MatheusOgata/TCC-FESP/escrita/experimental/28-10-noaa18/NOAA-IMG.jpg

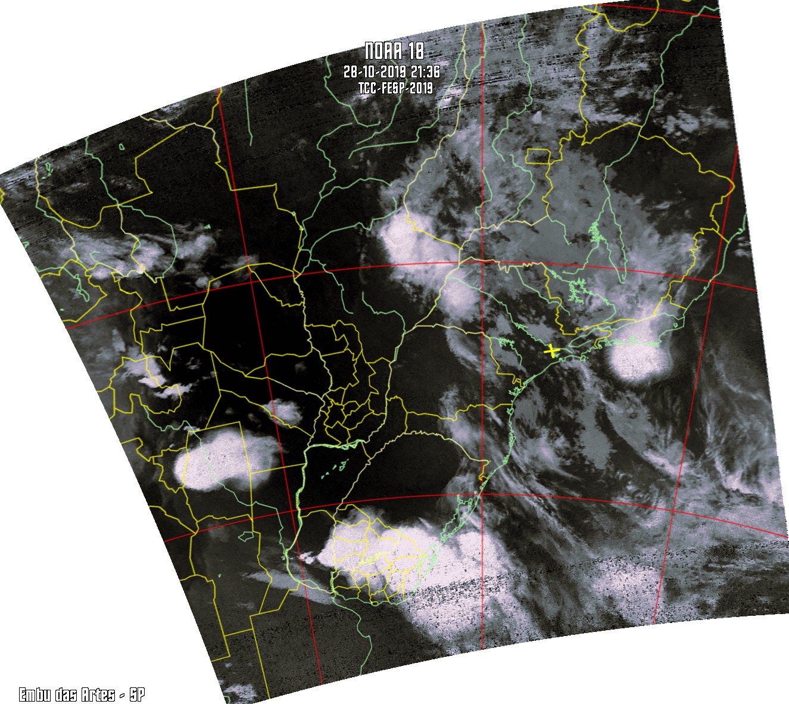
escrita/experimental/28-10-noaa18/NOAA-IMG.jpg
