MatheusOgata/TCC-FESP/escrita/experimental/record option.JPG

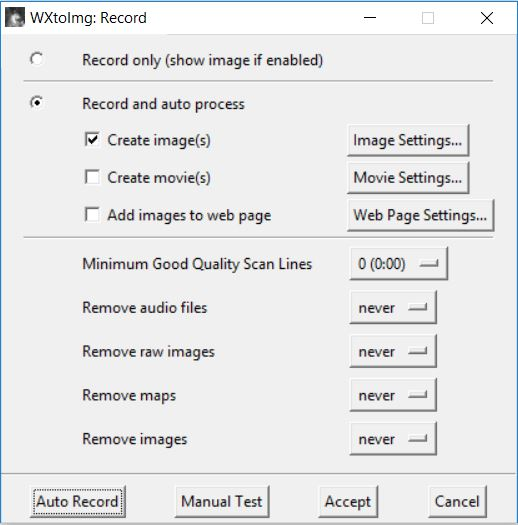
escrita/experimental/record option.JPG
