MatheusOgata/TCC-FESP/escrita/intro/blockstream3.png

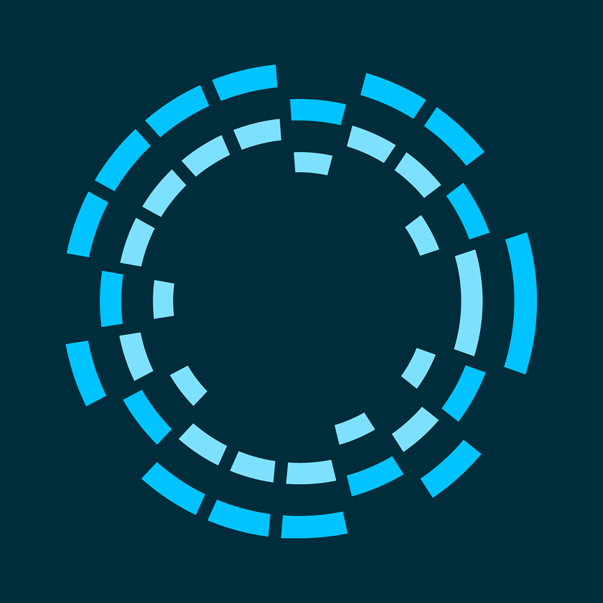
escrita/intro/blockstream3.png
