MatheusOgata/TCC-FESP/escrita/pesquisa-antena/plano de captura.JPG

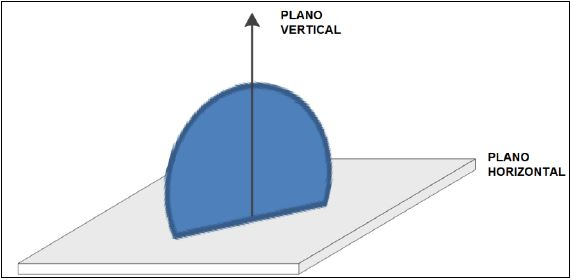
escrita/pesquisa-antena/plano de captura.JPG
