MatheusOgata/TCC-FESP/escrita/pesquisa-antena/simulacao modelo antena/medidas simulacao antena.JPG

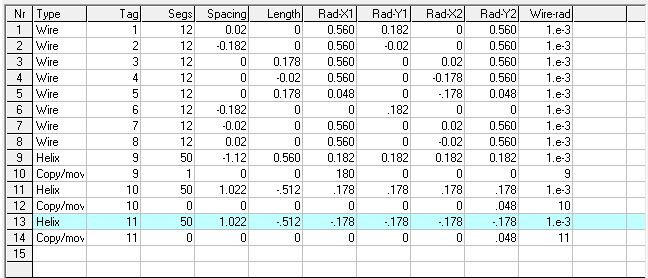
escrita/pesquisa-antena/simulacao modelo antena/medidas simulacao antena.JPG
