MatheusOgata/TCC-FESP/escrita/pesquisa-satelite/apt2.JPG

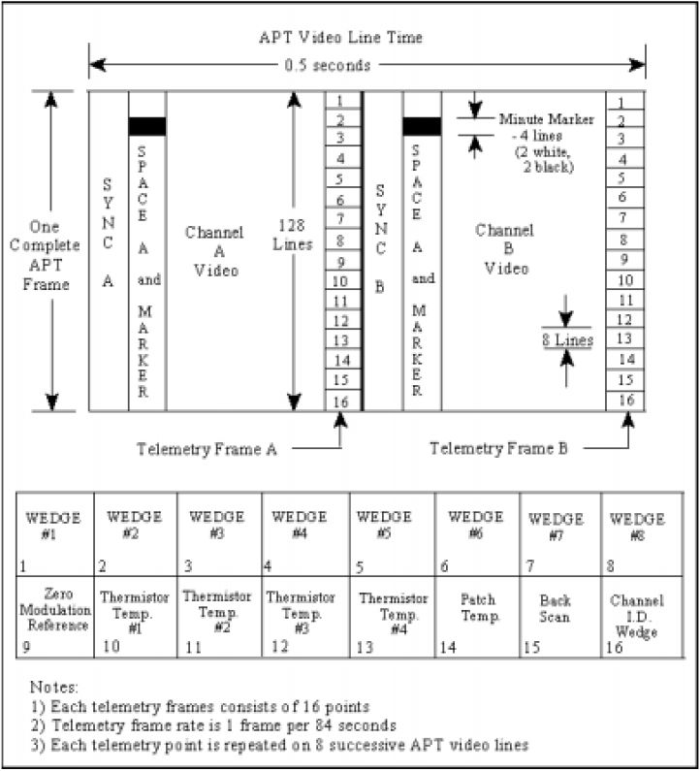
escrita/pesquisa-satelite/apt2.JPG
