MatheusOgata/TCC-FESP/escrita/pesquisa-satelite/AVHRR.jpg

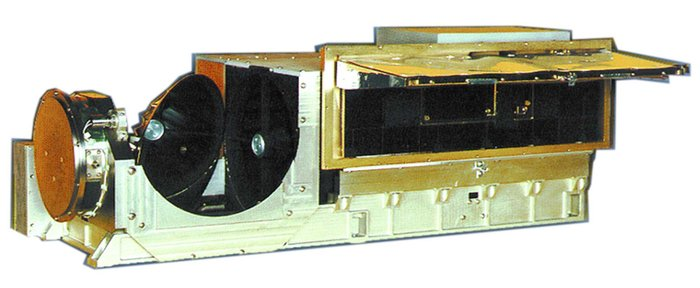
escrita/pesquisa-satelite/AVHRR.jpg
