MatheusOgata/TCC-FESP/escrita/pesquisa-satelite/BANDEIRA NOAA.png

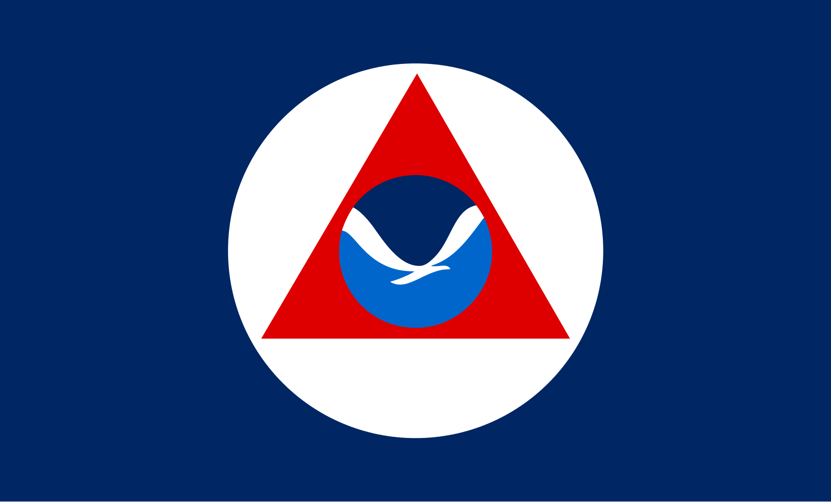
escrita/pesquisa-satelite/BANDEIRA NOAA.png
