MatheusOgata/TCC-FESP/escrita/pesquisa-satelite/color hrpt.JPG

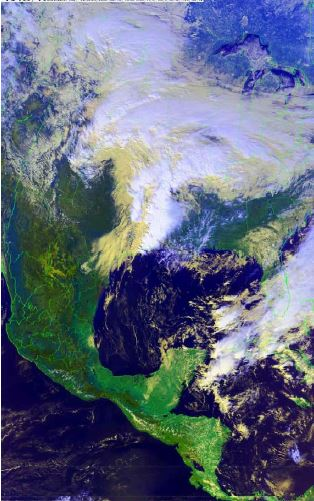
escrita/pesquisa-satelite/color hrpt.JPG
