MatheusOgata/TCC-FESP/escrita/pesquisa-satelite/escanemento.JPG

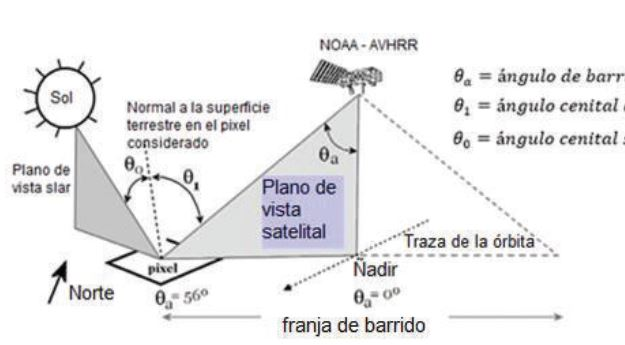
escrita/pesquisa-satelite/escanemento.JPG
