MatheusOgata/TCC-FESP/escrita/pesquisa-satelite/noaa19.jpg

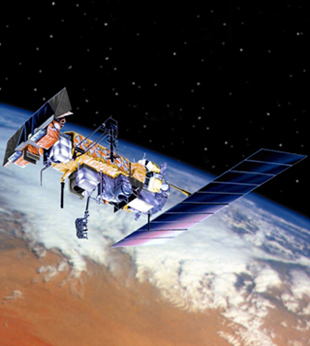
escrita/pesquisa-satelite/noaa19.jpg
