MatheusOgata/TCC-FESP/escrita/pesquisa-satelite/noaa subsistemas.JPG

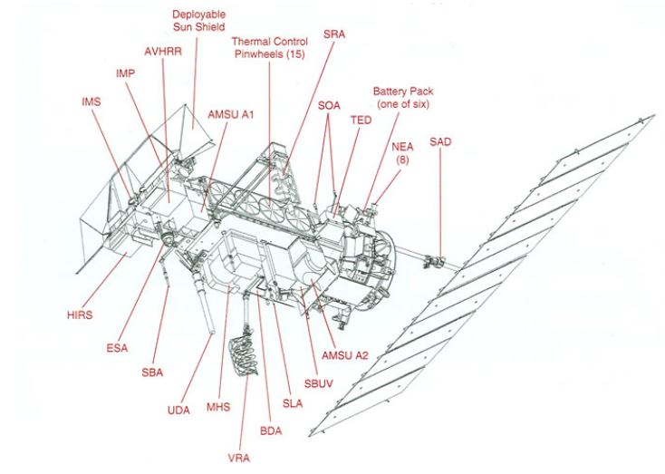
escrita/pesquisa-satelite/noaa subsistemas.JPG
