MatheusOgata/TCC-FESP/escrita/pesquisa-satelite/sistema espacial.JPG

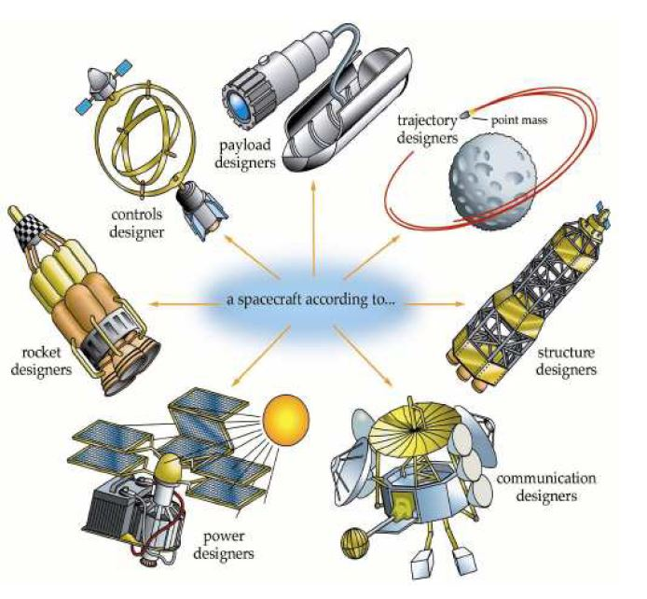
escrita/pesquisa-satelite/sistema espacial.JPG
