MatheusOgata/TCC-FESP/escrita/pesquisa-satelite/US DEP COMMERCE.png

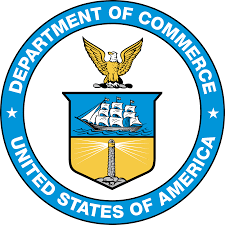
escrita/pesquisa-satelite/US DEP COMMERCE.png
