MatheusOgata/TCC-FESP/escrita/experimental/4h58-noaa19-1709/NOAA-IMG5.jpg

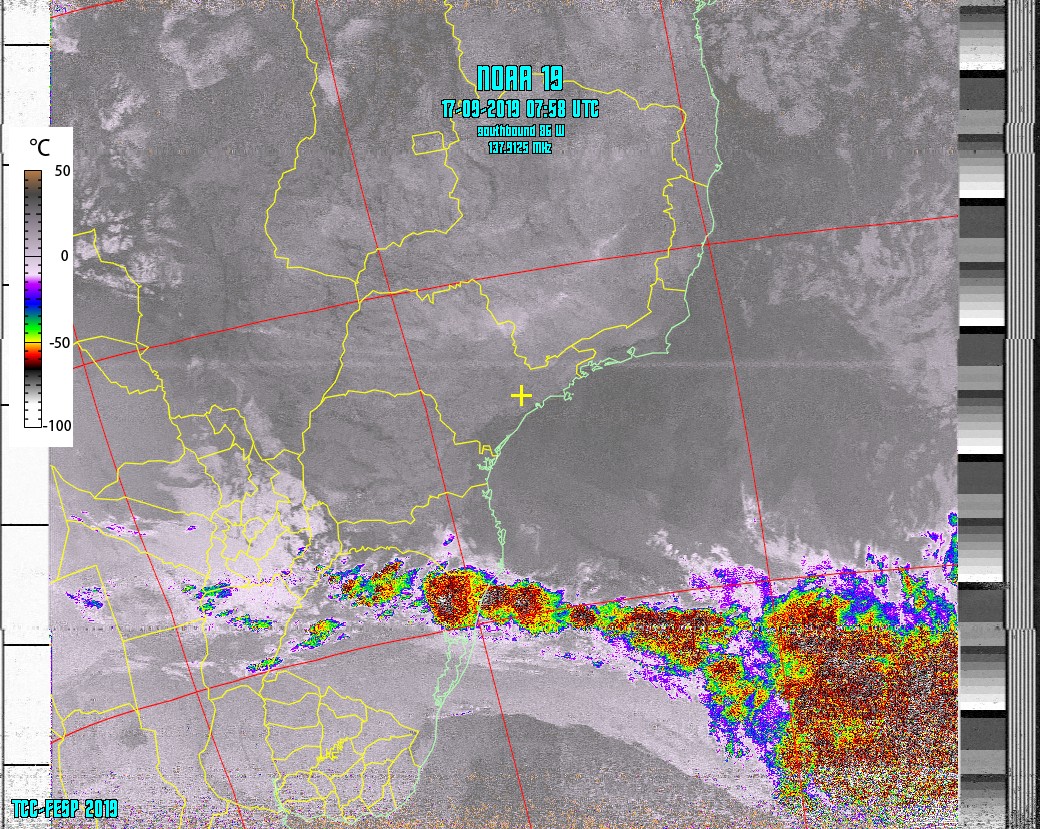
escrita/experimental/4h58-noaa19-1709/NOAA-IMG5.jpg
