MatheusOgata/TCC-FESP/escrita/experimental/4h58-noaa19-1709/nuvens-relevo-ir.jpg

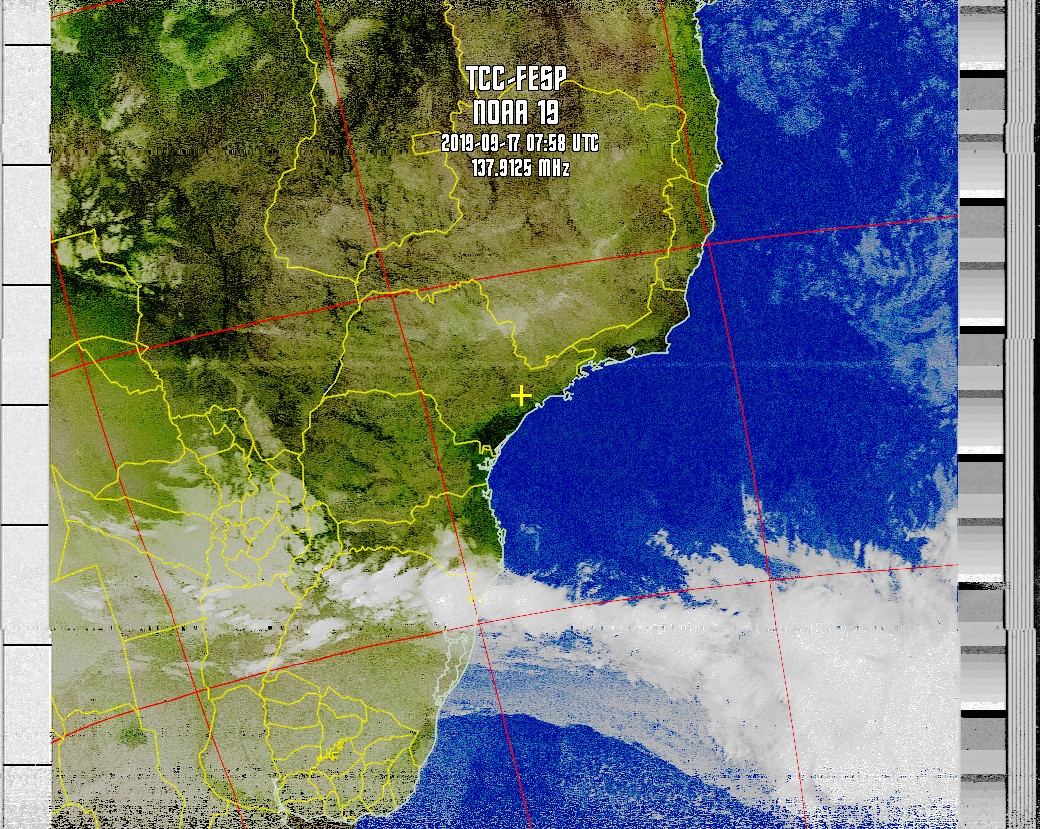
escrita/experimental/4h58-noaa19-1709/nuvens-relevo-ir.jpg
