MatheusOgata/TCC-FESP/escrita/experimental/5h-noaa19-1609/11.JPG

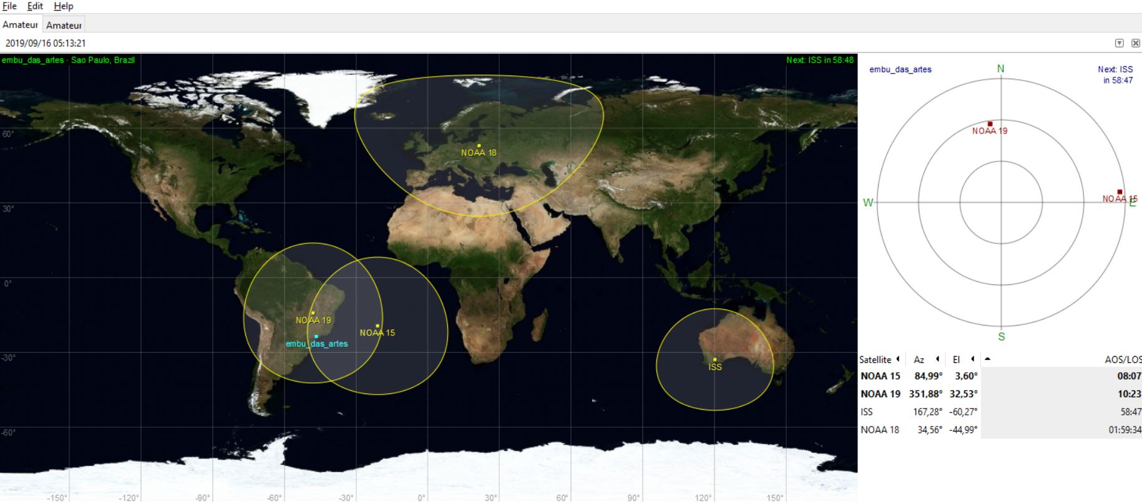
escrita/experimental/5h-noaa19-1609/11.JPG
