MatheusOgata/TCC-FESP/escrita/experimental/5h-noaa19-1609/22.JPG

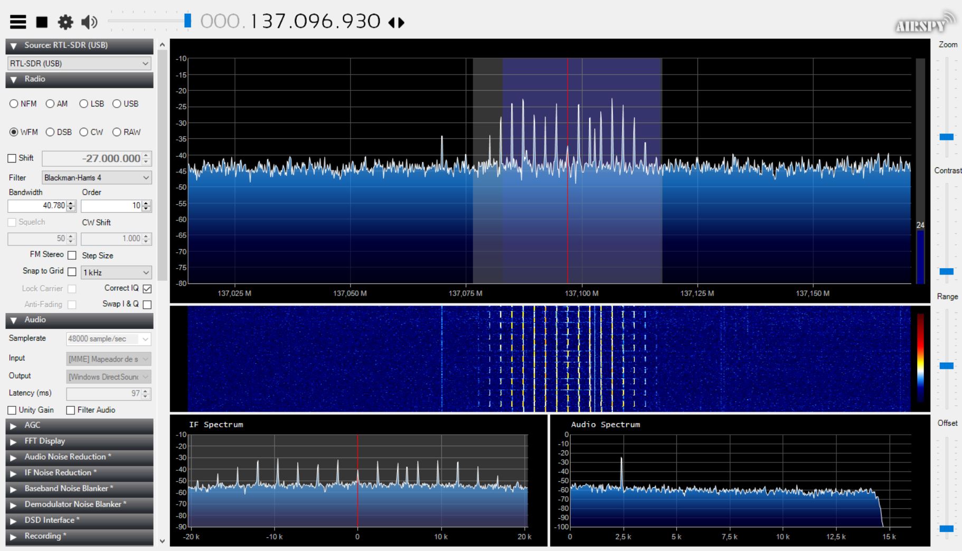
escrita/experimental/5h-noaa19-1609/22.JPG
