MatheusOgata/TCC-FESP/escrita/experimental/5h-noaa19-1609/33.JPG

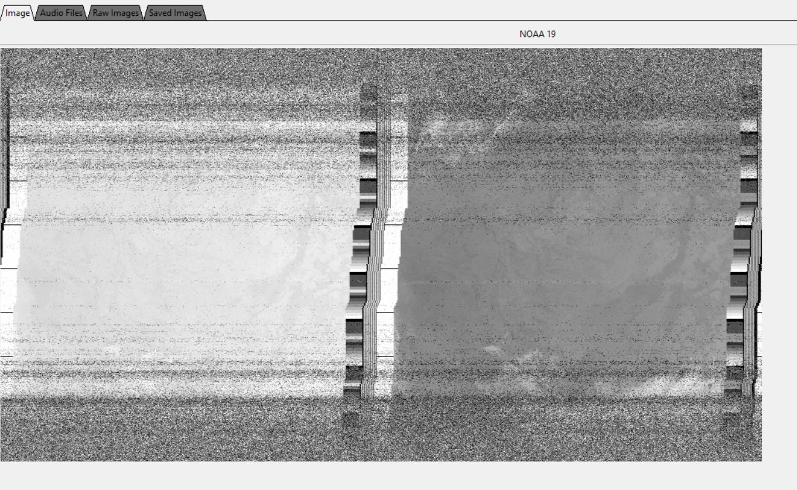
escrita/experimental/5h-noaa19-1609/33.JPG
