MatheusOgata/TCC-FESP/escrita/experimental/5h-noaa19-1609/noaa19termal.jpg

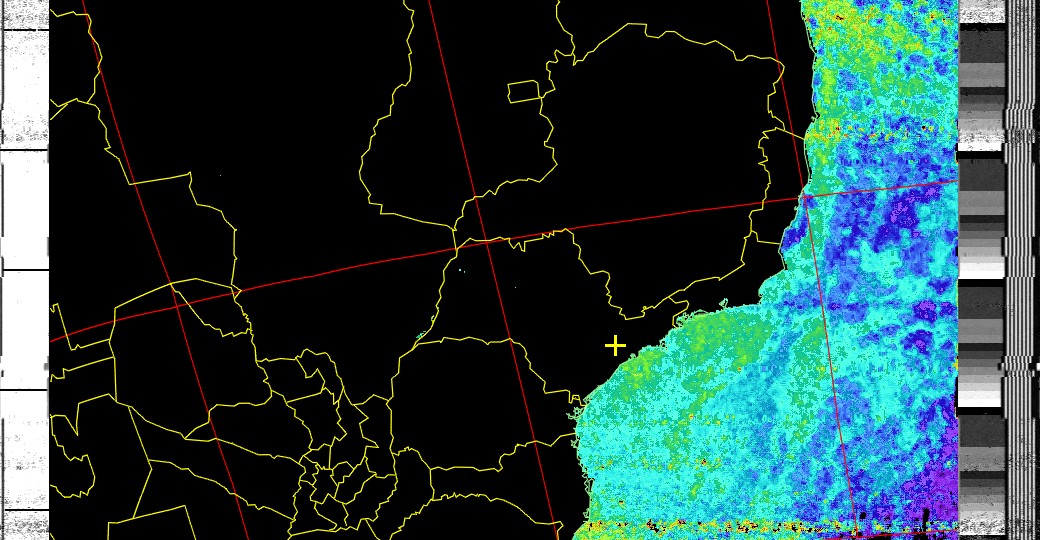
escrita/experimental/5h-noaa19-1609/noaa19termal.jpg
