MatheusOgata/TCC-FESP/escrita/experimental/5h-noaa19-1609/noaa19thermal2.jpg

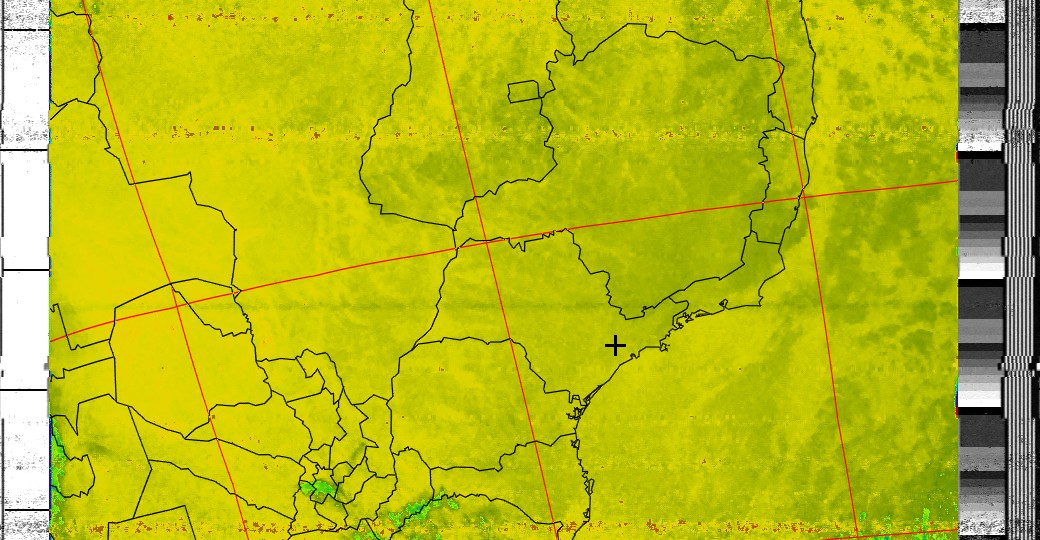
escrita/experimental/5h-noaa19-1609/noaa19thermal2.jpg
