MatheusOgata/TCC-FESP/escrita/experimental/5h-noaa19-1609/noaa-19-201909160810-mcir.jpg

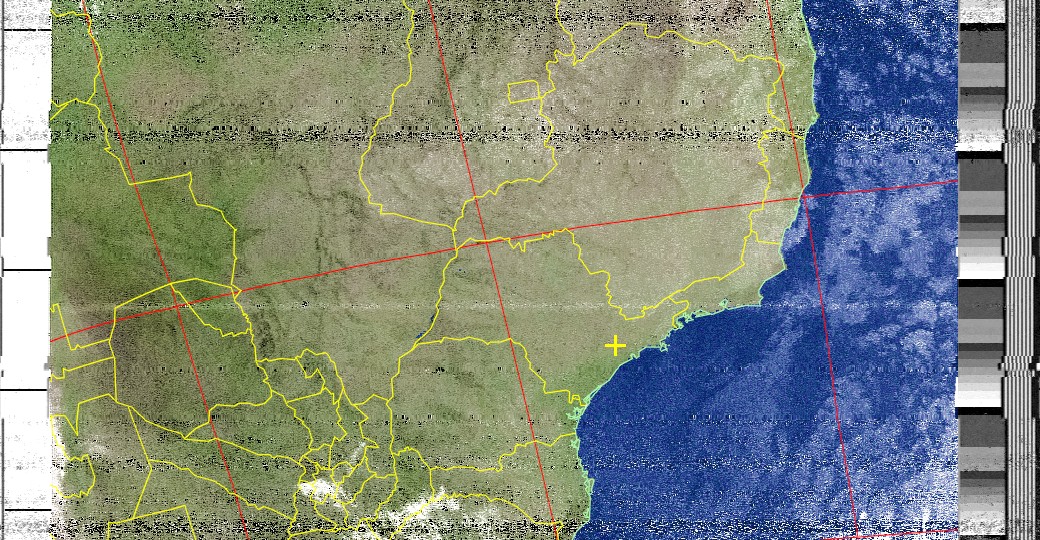
escrita/experimental/5h-noaa19-1609/noaa-19-201909160810-mcir.jpg
