MatheusOgata/TCC-FESP/escrita/experimental/8h30-noaa-18-1310/NOAA-18-13-10-prec.jpg

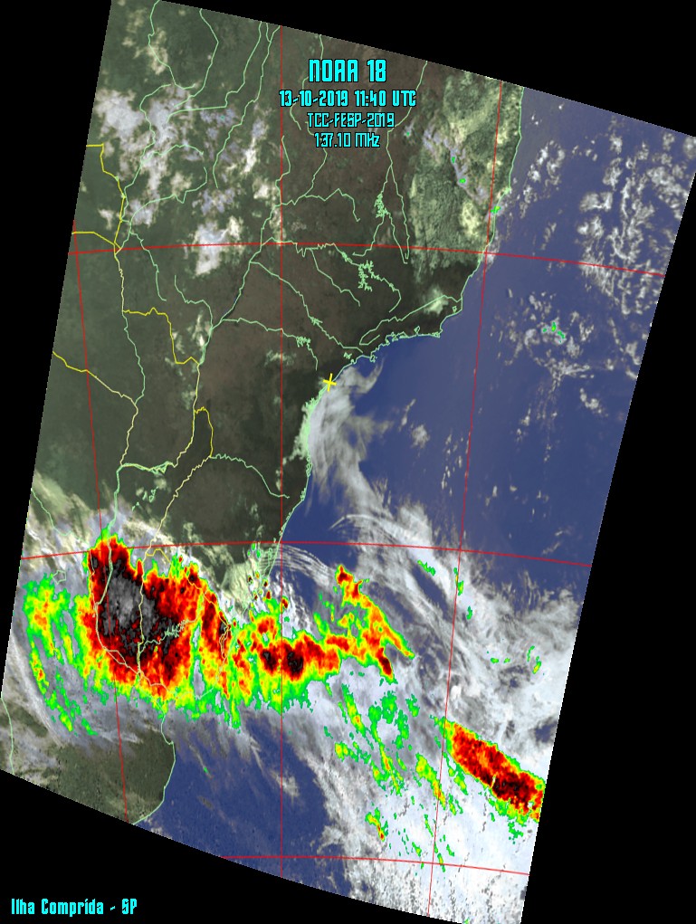
escrita/experimental/8h30-noaa-18-1310/NOAA-18-13-10-prec.jpg
