MatheusOgata/TCC-FESP/escrita/experimental/8h30-noaa-18-1310/weather-channel-13-10-precipitacao.JPG

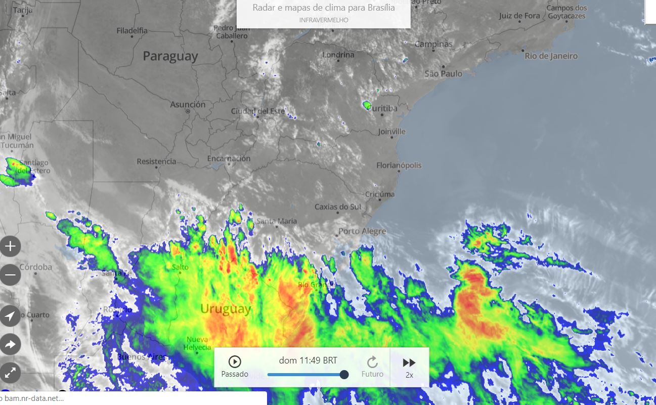
escrita/experimental/8h30-noaa-18-1310/weather-channel-13-10-precipitacao.JPG
