MatheusOgata/TCC-FESP/escrita/experimental/12-10-noaa19/12-10-noaa19.png

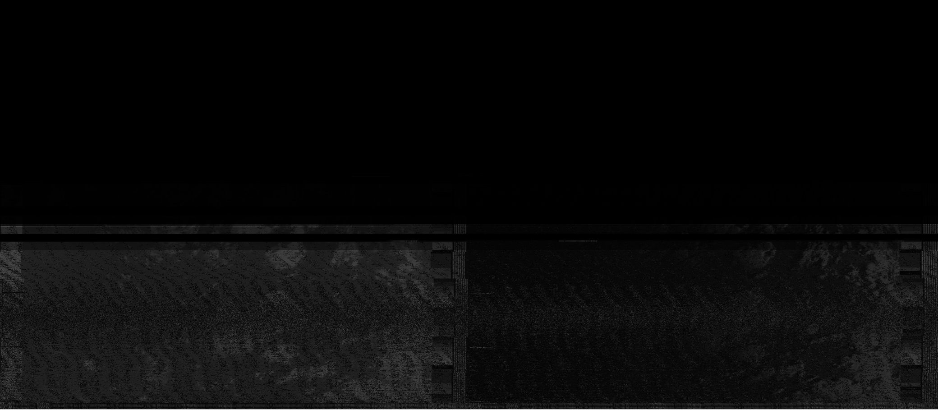
escrita/experimental/12-10-noaa19/12-10-noaa19.png
