MatheusOgata/TCC-FESP/escrita/experimental/16-10-noaa15/16-10-noaa15.png

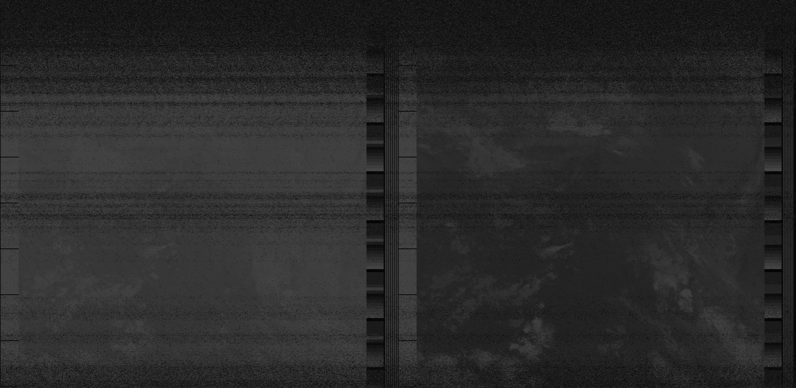
escrita/experimental/16-10-noaa15/16-10-noaa15.png
