MatheusOgata/TCC-FESP/escrita/experimental/17-09-noaa15/NOAA15-6h20-17092019.png

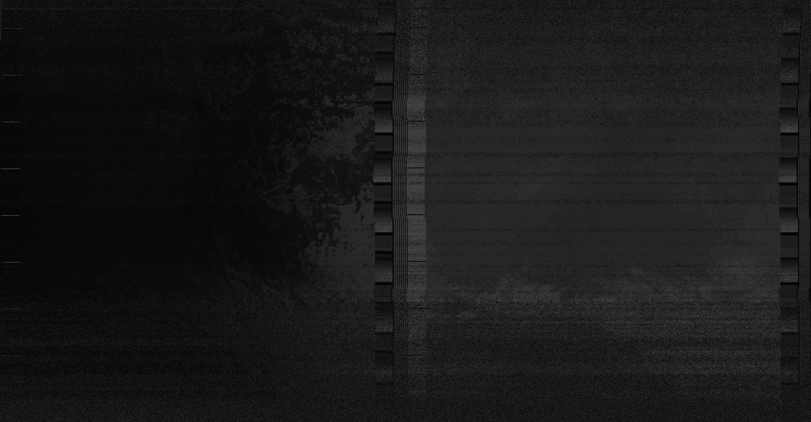
escrita/experimental/17-09-noaa15/NOAA15-6h20-17092019.png
