MatheusOgata/TCC-FESP/escrita/experimental/18-10-noaa15/18-10-noaa15.png

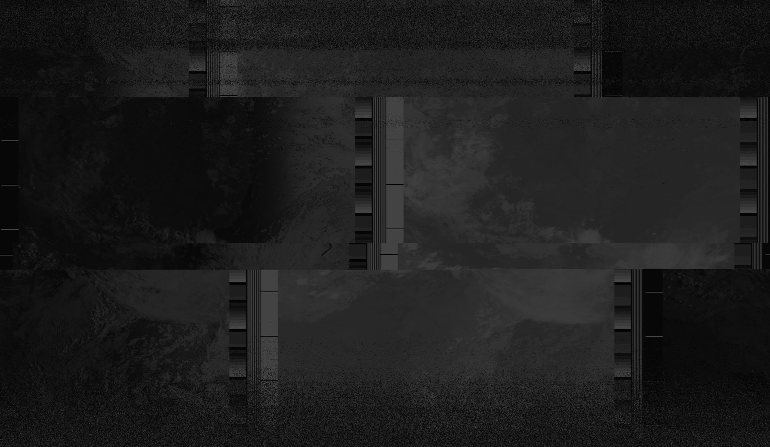
escrita/experimental/18-10-noaa15/18-10-noaa15.png
