MatheusOgata/TCC-FESP/escrita/experimental/19-10-noaa15/19-10-noaa15.png

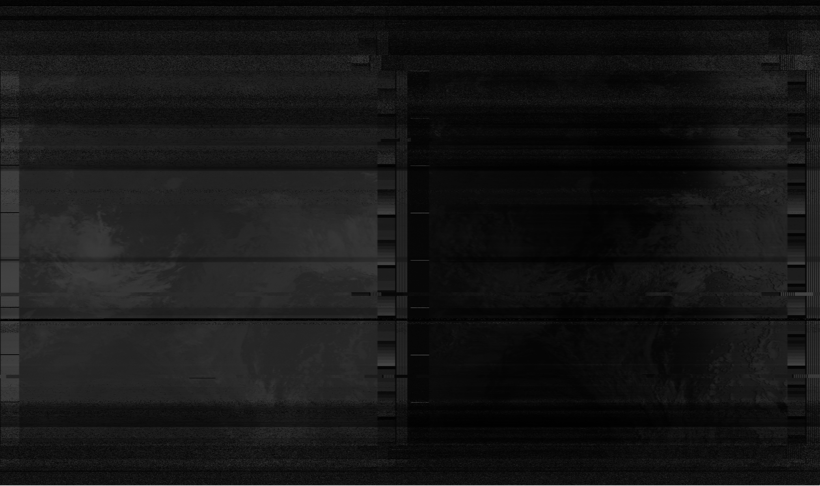
escrita/experimental/19-10-noaa15/19-10-noaa15.png
