MatheusOgata/TCC-FESP/escrita/experimental/19-10-noaa18/19-10-noaa18-comparacao.JPG

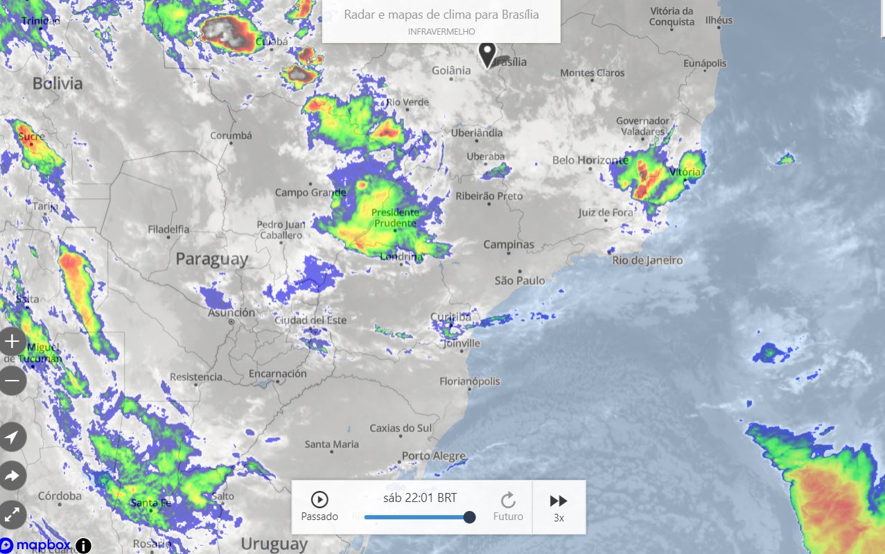
escrita/experimental/19-10-noaa18/19-10-noaa18-comparacao.JPG
