MatheusOgata/TCC-FESP/escrita/experimental/19-10-noaa18/19-10-noaa18.png

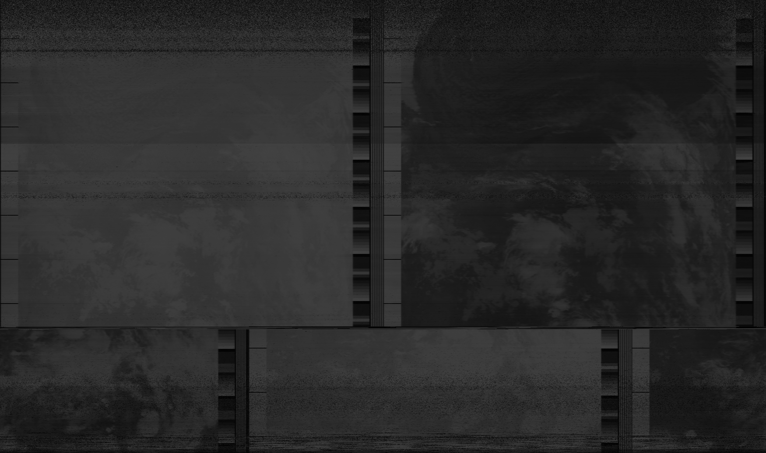
escrita/experimental/19-10-noaa18/19-10-noaa18.png
