MatheusOgata/TCC-FESP/escrita/experimental/19h50-noaa-18-1509/noaa-18-201909151955-norm.jpg

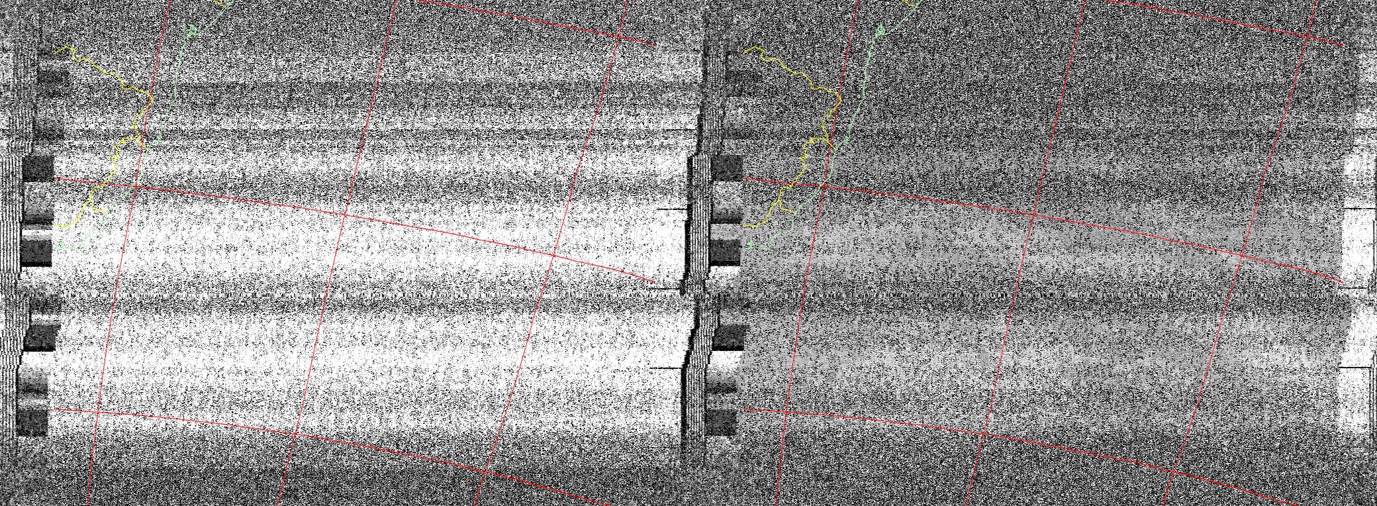
escrita/experimental/19h50-noaa-18-1509/noaa-18-201909151955-norm.jpg
