MatheusOgata/TCC-FESP/escrita/experimental/19h50-noaa-18-1509/noaa-19-16h19-15-09.jpg

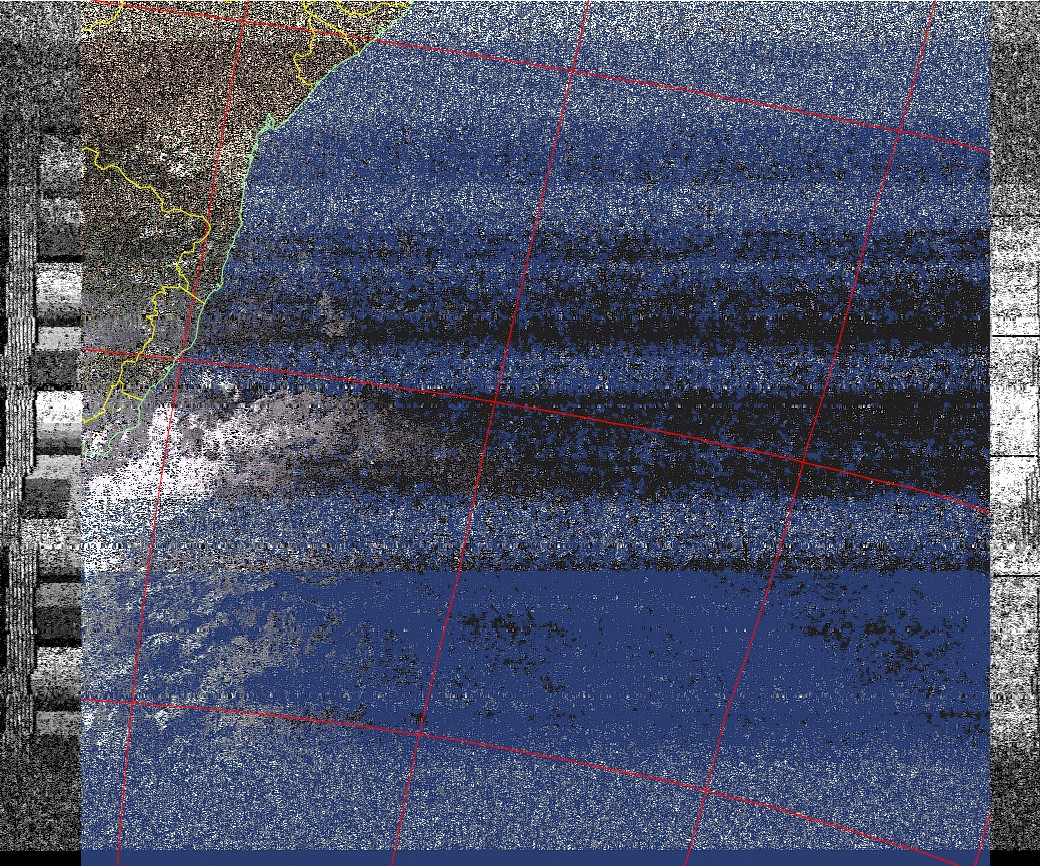
escrita/experimental/19h50-noaa-18-1509/noaa-19-16h19-15-09.jpg
