MatheusOgata/TCC-FESP/escrita/experimental/19h50-noaa-18-1509/noaa-19-201909151914-norm.jpg

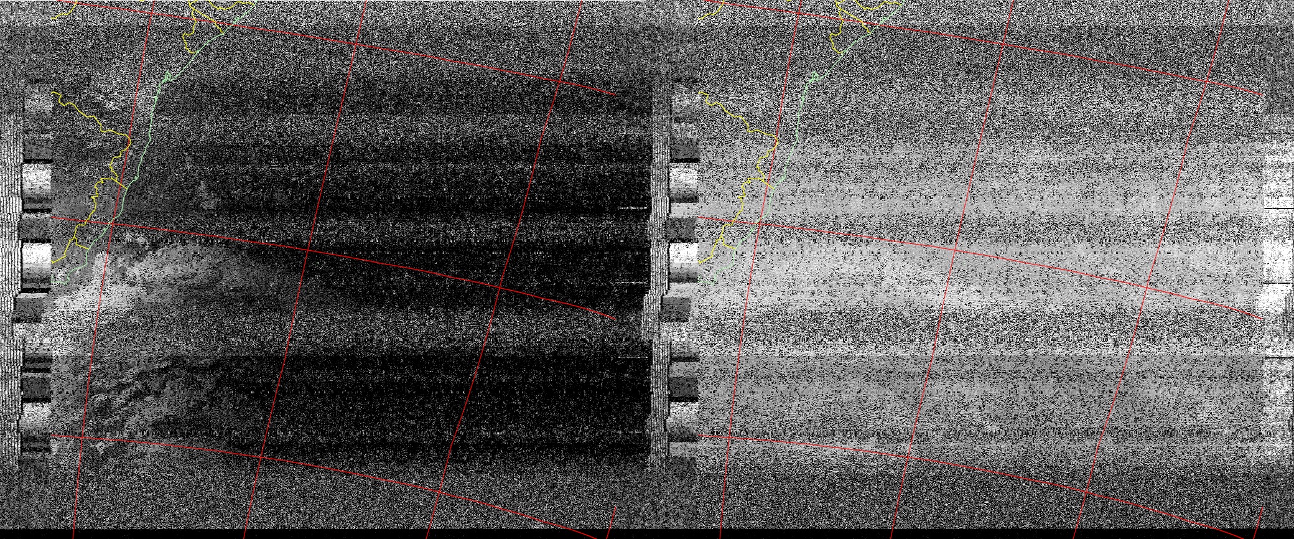
escrita/experimental/19h50-noaa-18-1509/noaa-19-201909151914-norm.jpg
