MatheusOgata/TCC-FESP/escrita/experimental/21-10-noaa18/21-10-noaa18-comparacao.JPG

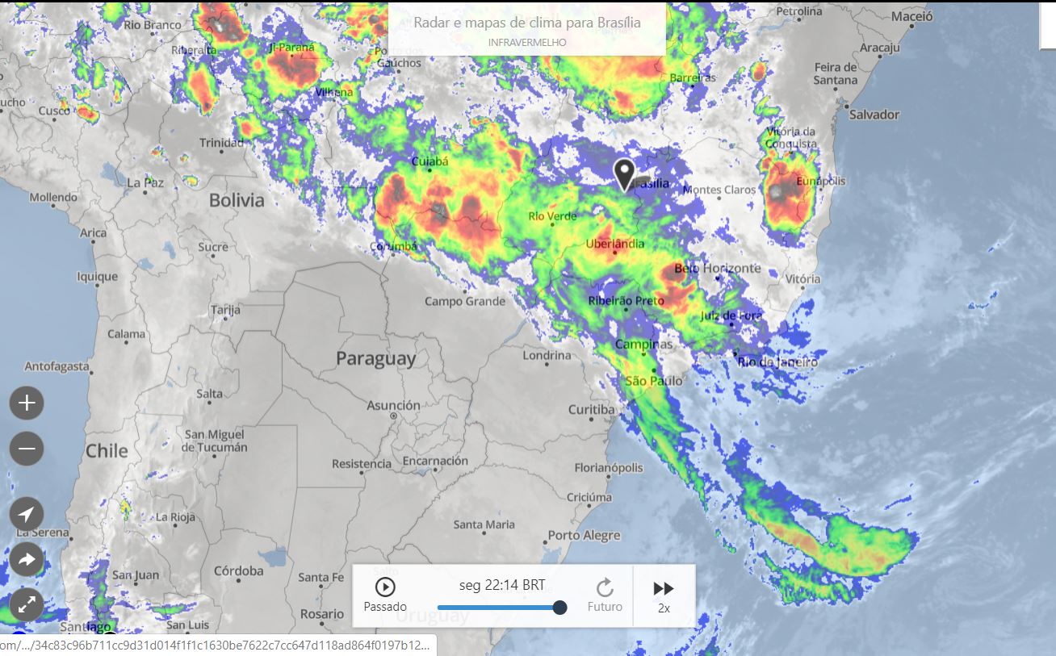
escrita/experimental/21-10-noaa18/21-10-noaa18-comparacao.JPG
