MatheusOgata/TCC-FESP/escrita/experimental/21h18-noaa18-2110/NOAA18-IMG2.jpg

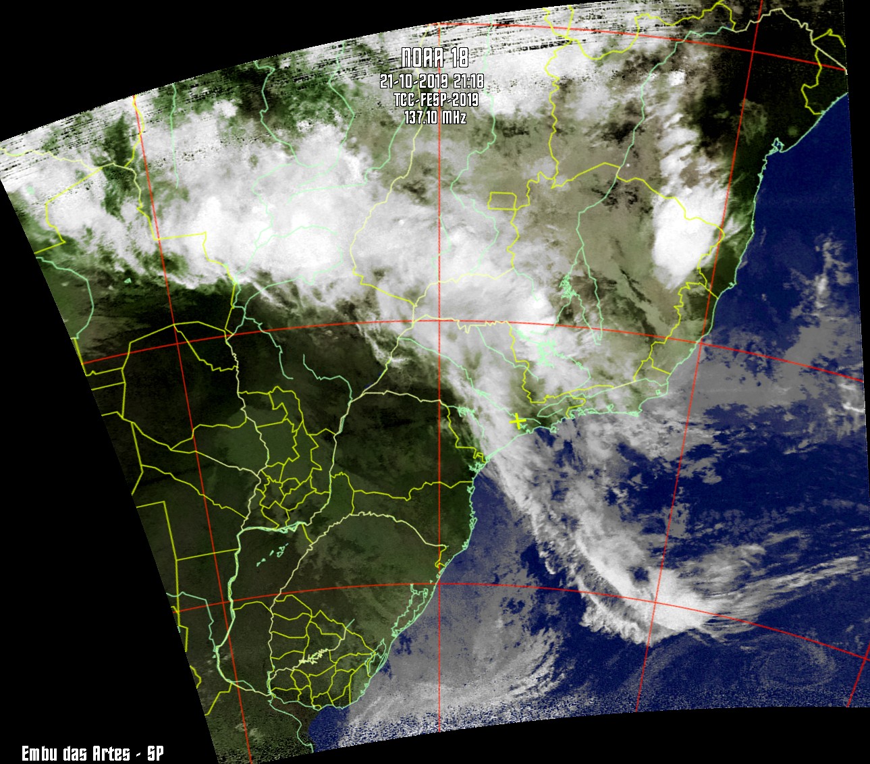
escrita/experimental/21h18-noaa18-2110/NOAA18-IMG2.jpg
