MatheusOgata/TCC-FESP/escrita/experimental/21h20-noaa18-1210/NOAA18-IMG-12-10-precipitaÃ§Ã£o.jpg

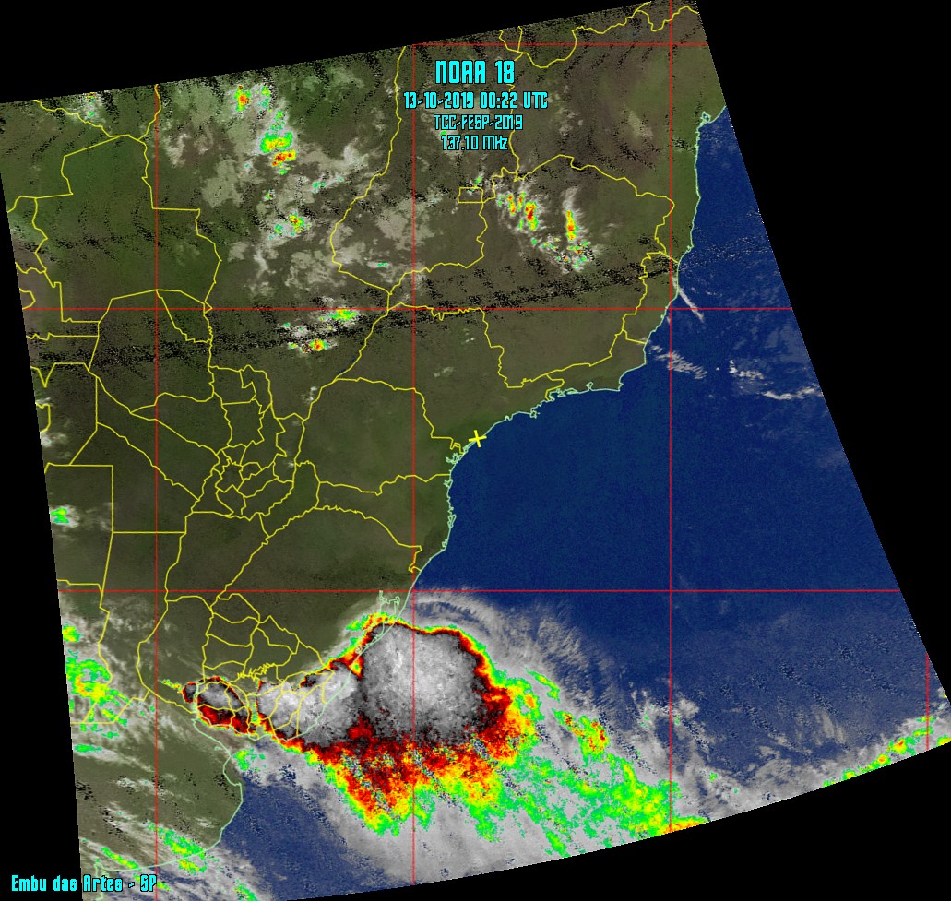
escrita/experimental/21h20-noaa18-1210/NOAA18-IMG-12-10-precipitaÃ§Ã£o.jpg
