MatheusOgata/TCC-FESP/escrita/experimental/21h20-noaa18-1210/weather-channel-12-10.JPG

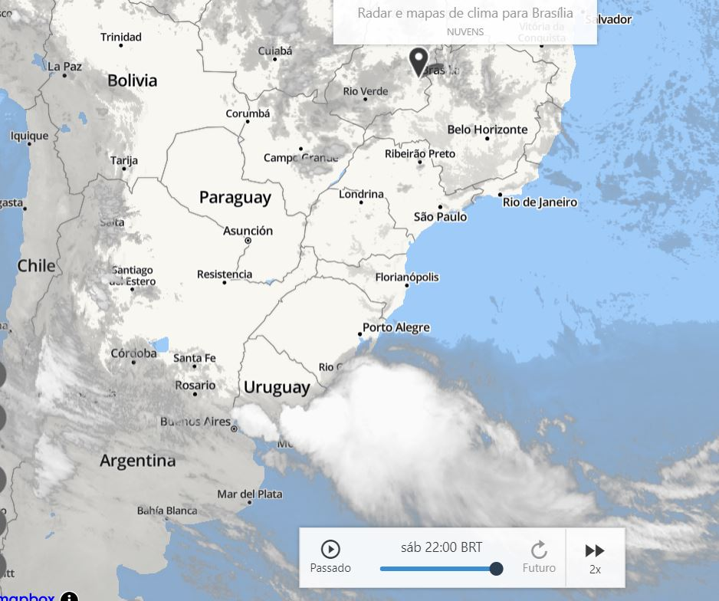
escrita/experimental/21h20-noaa18-1210/weather-channel-12-10.JPG
