MatheusOgata/TCC-FESP/escrita/experimental/21h30-noaa18-1509/noaa-18-201909160036-no.jpg

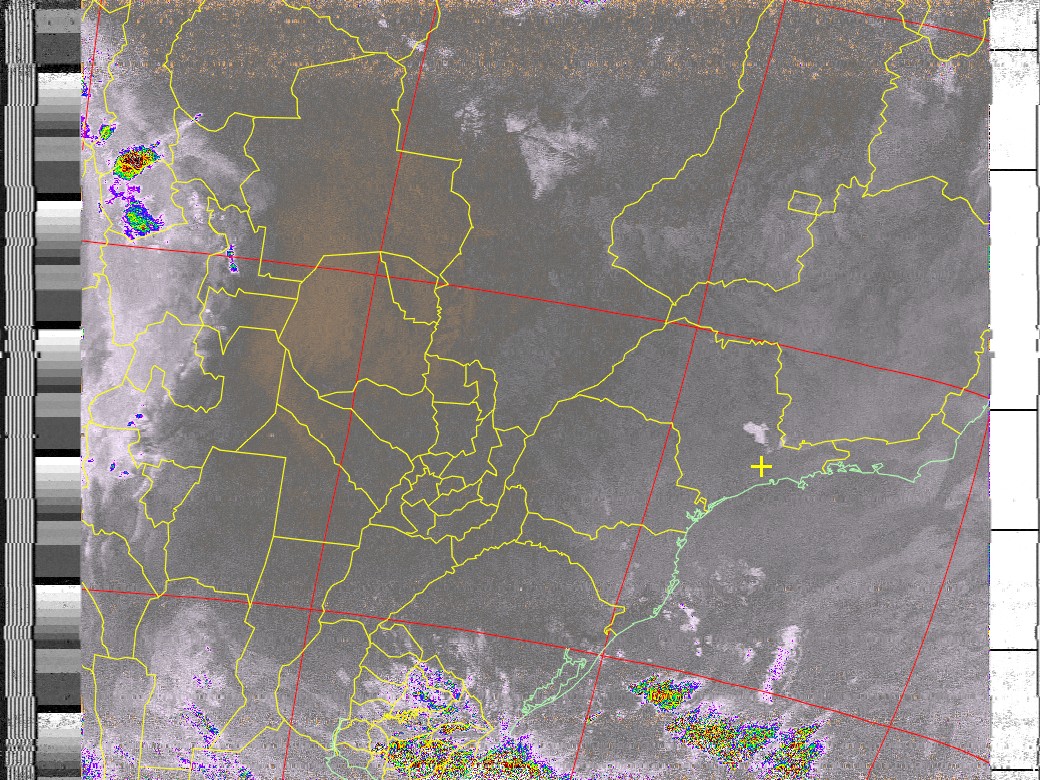
escrita/experimental/21h30-noaa18-1509/noaa-18-201909160036-no.jpg
