MatheusOgata/TCC-FESP/escrita/experimental/21h30-noaa18-1509/NOAA-IMG-sea-temperature.jpg

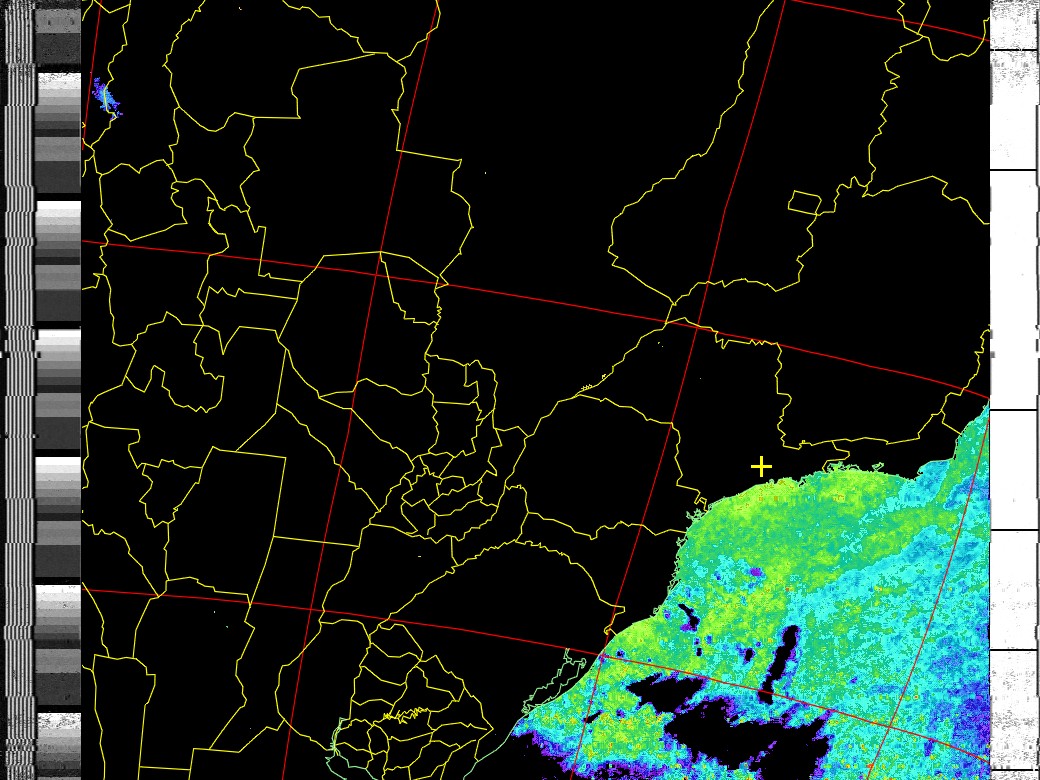
escrita/experimental/21h30-noaa18-1509/NOAA-IMG-sea-temperature.jpg
