MatheusOgata/TCC-FESP/escrita/experimental/22-10-noaa15/22-10-noaa15-comparacao-melhor-extensao.JPG

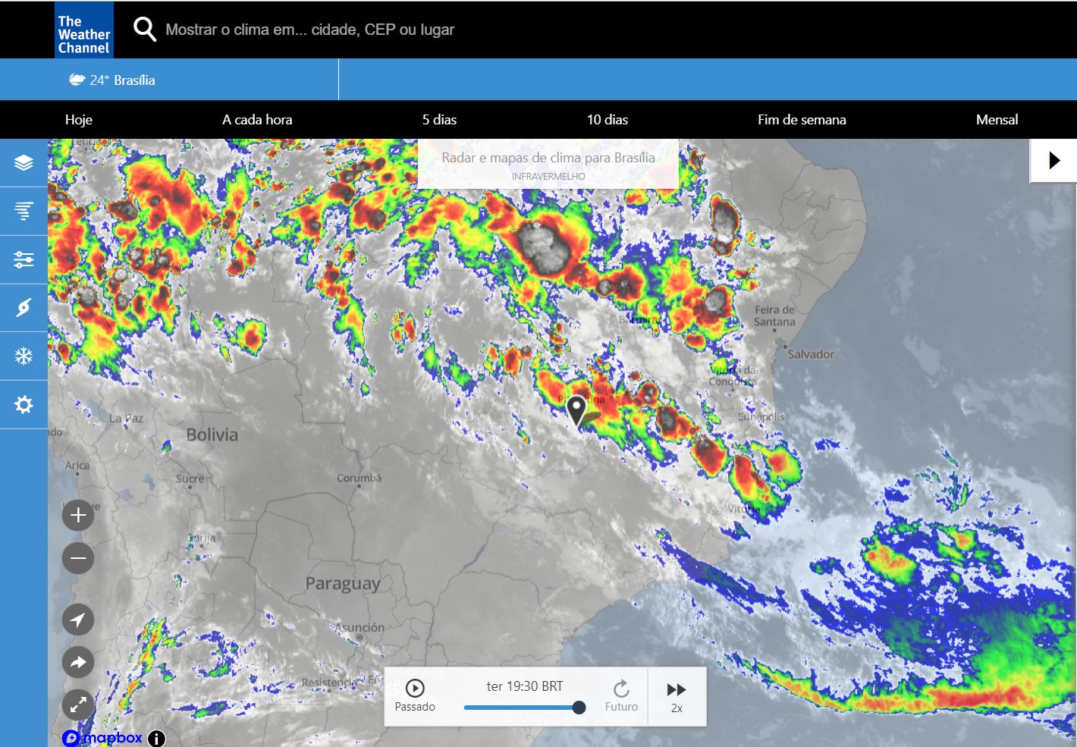
escrita/experimental/22-10-noaa15/22-10-noaa15-comparacao-melhor-extensao.JPG
