MatheusOgata/TCC-FESP/escrita/experimental/22-10-noaa15/elevacao-noaa15.JPG

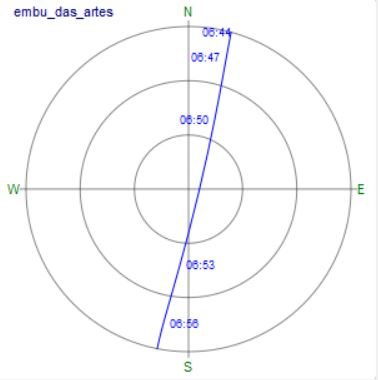
escrita/experimental/22-10-noaa15/elevacao-noaa15.JPG
