MatheusOgata/TCC-FESP/escrita/experimental/22-10-noaa15/NOAA-IMG.jpg

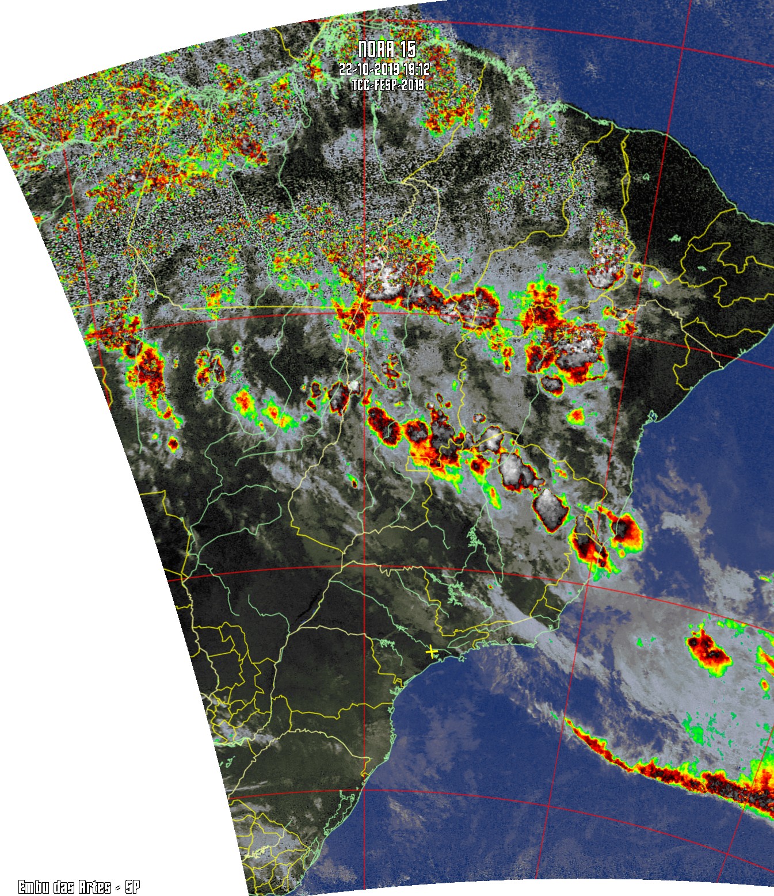
escrita/experimental/22-10-noaa15/NOAA-IMG.jpg
