MatheusOgata/TCC-FESP/escrita/experimental/22-10-noaa18/ótima_passagem_noaa18.JPG

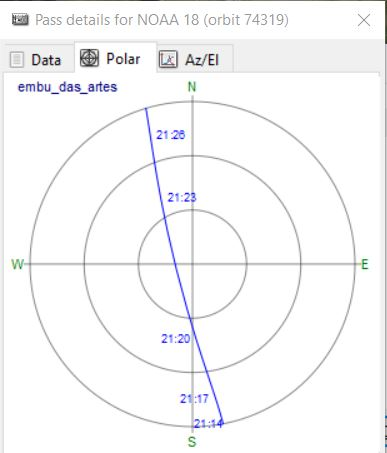
escrita/experimental/22-10-noaa18/ótima_passagem_noaa18.JPG
