MatheusOgata/TCC-FESP/escrita/experimental/23-10-noaa15/23-10-noaa15-raw.png

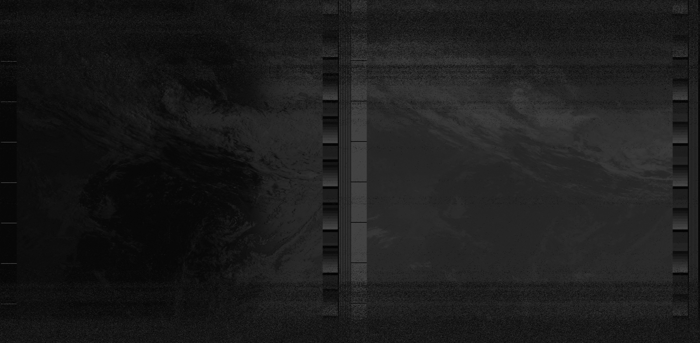
escrita/experimental/23-10-noaa15/23-10-noaa15-raw.png
