MatheusOgata/TCC-FESP/escrita/experimental/23-10-noaa15/NOAA-IMG.jpg

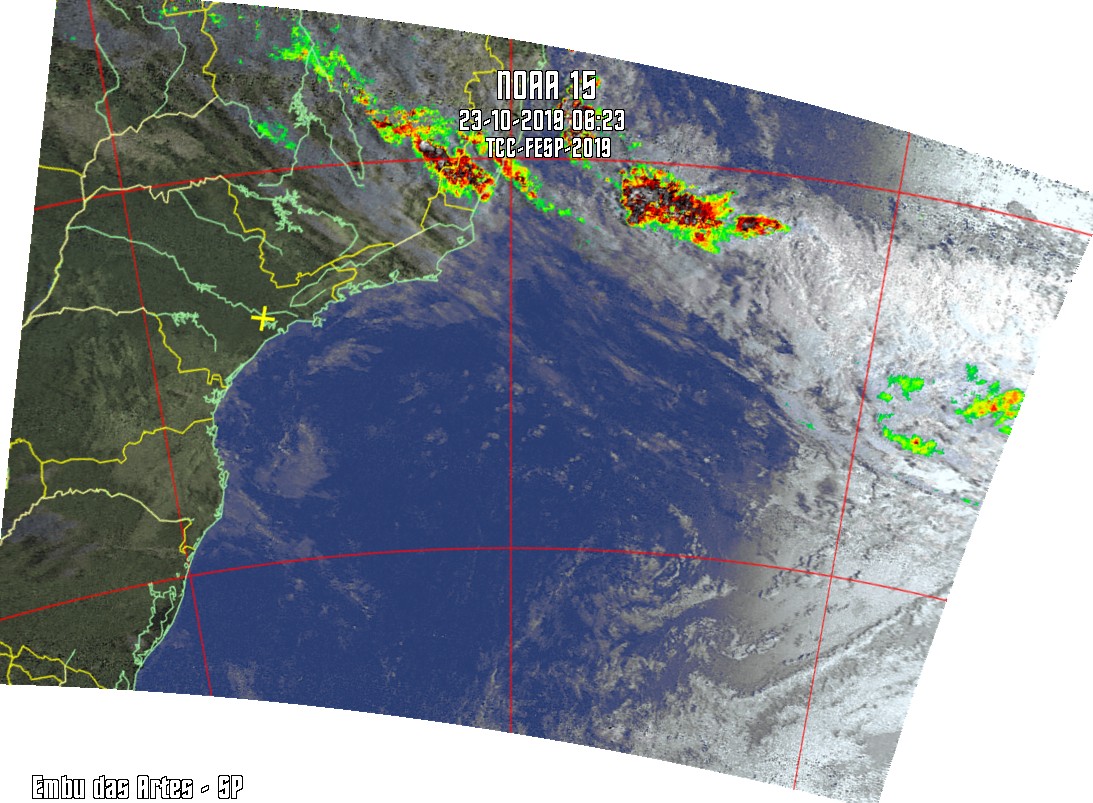
escrita/experimental/23-10-noaa15/NOAA-IMG.jpg
