MatheusOgata/TCC-FESP/escrita/experimental/25-10-noaa15/25-10-noaa15-raw.png

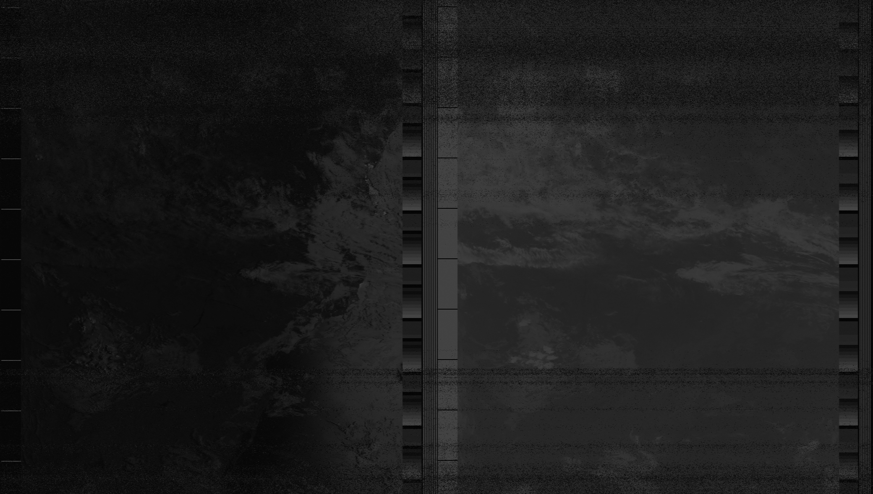
escrita/experimental/25-10-noaa15/25-10-noaa15-raw.png
