MatheusOgata/TCC-FESP/escrita/experimental/27-10-noaa18/27-10-noaa18.png

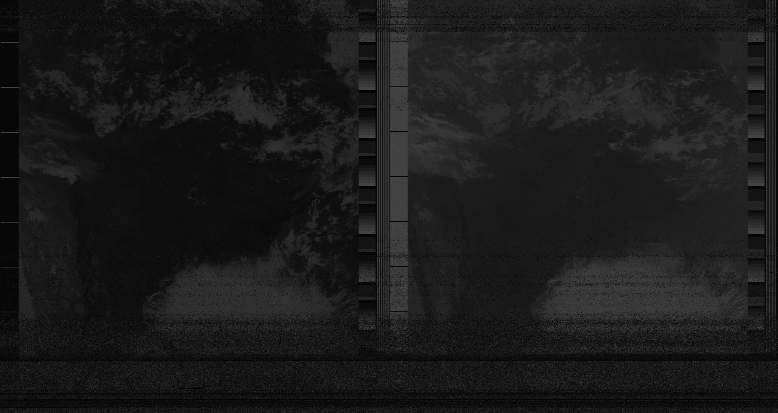
escrita/experimental/27-10-noaa18/27-10-noaa18.png
