MatheusOgata/TCC-FESP/escrita/experimental/28-10-noaa18/28-10-noaa18.png

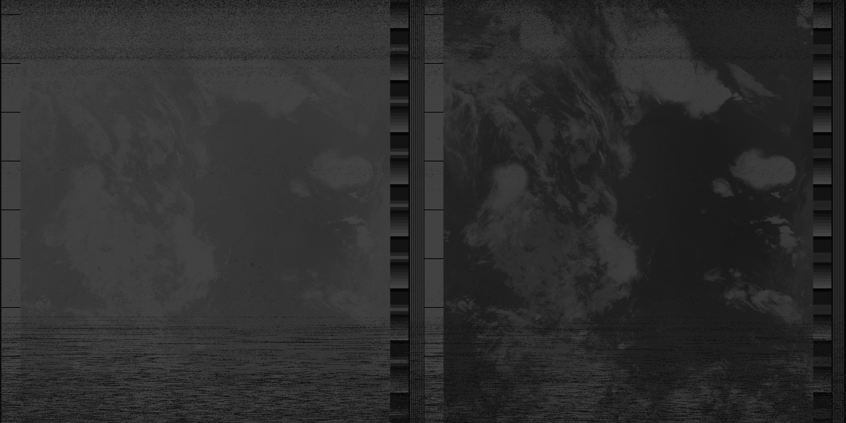
escrita/experimental/28-10-noaa18/28-10-noaa18.png
