MatheusOgata/TCC-FESP/escrita/experimental/28-10-noaa18/NOAA-IMG2.jpg

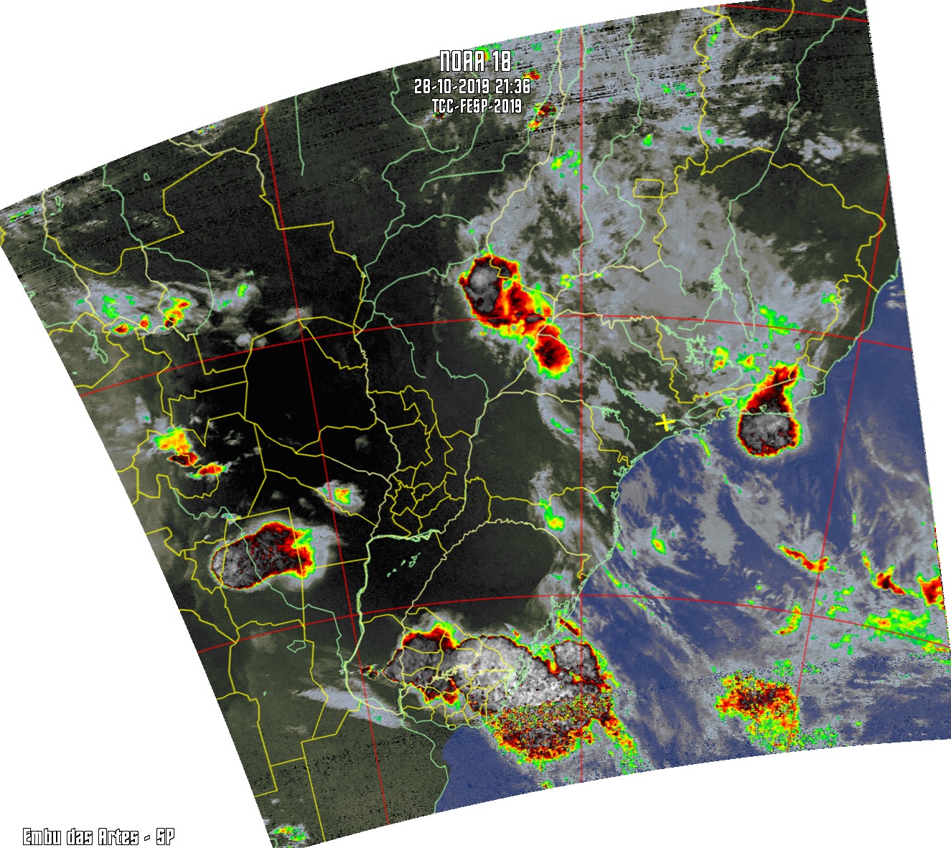
escrita/experimental/28-10-noaa18/NOAA-IMG2.jpg
