MatheusOgata/TCC-FESP/escrita/experimental/28-10-noaa19/comparar.JPG

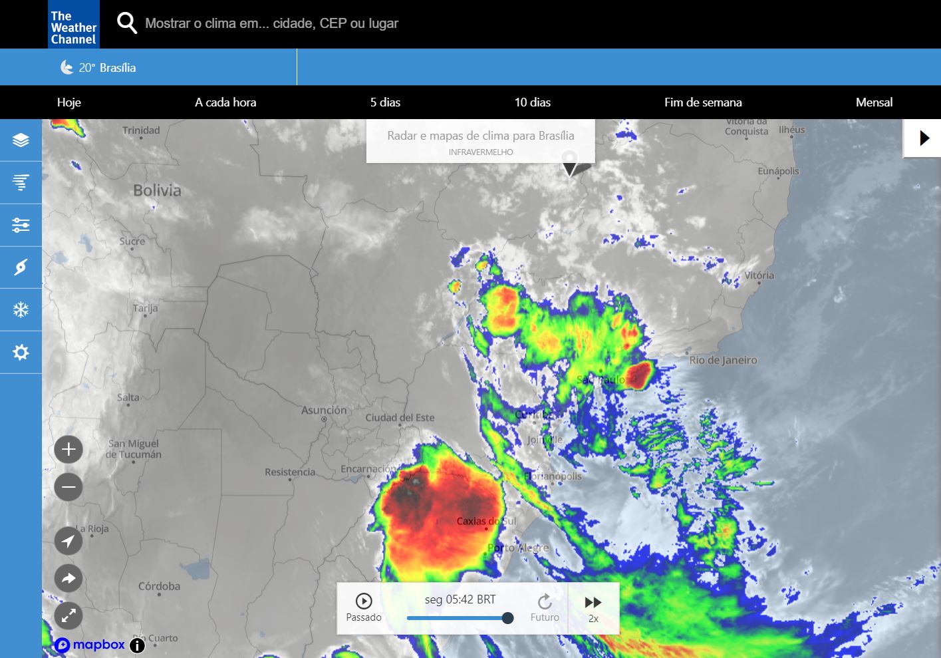
escrita/experimental/28-10-noaa19/comparar.JPG
