MatheusOgata/TCC-FESP/escrita/experimental/Capturar1.JPG

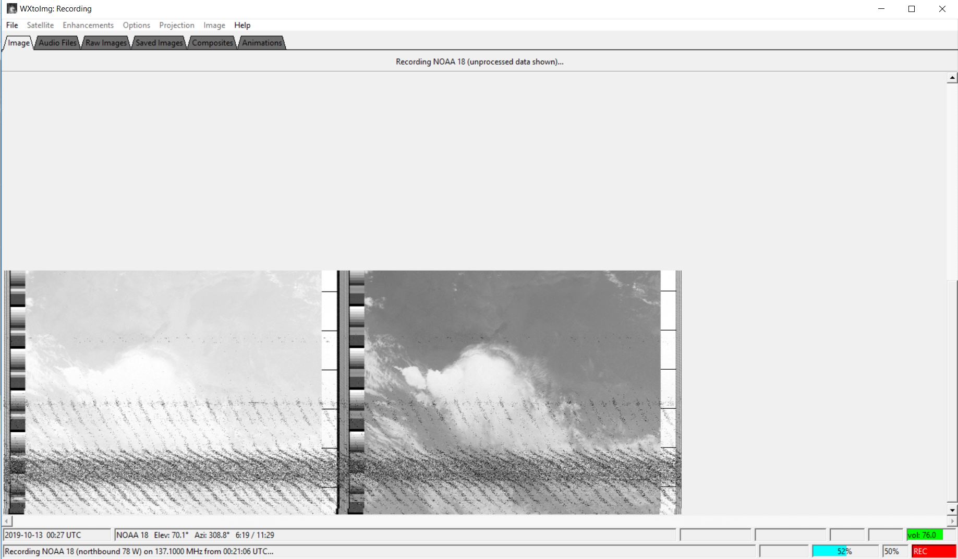
escrita/experimental/Capturar1.JPG
