MatheusOgata/TCC-FESP/escrita/experimental/Capturar.JPG

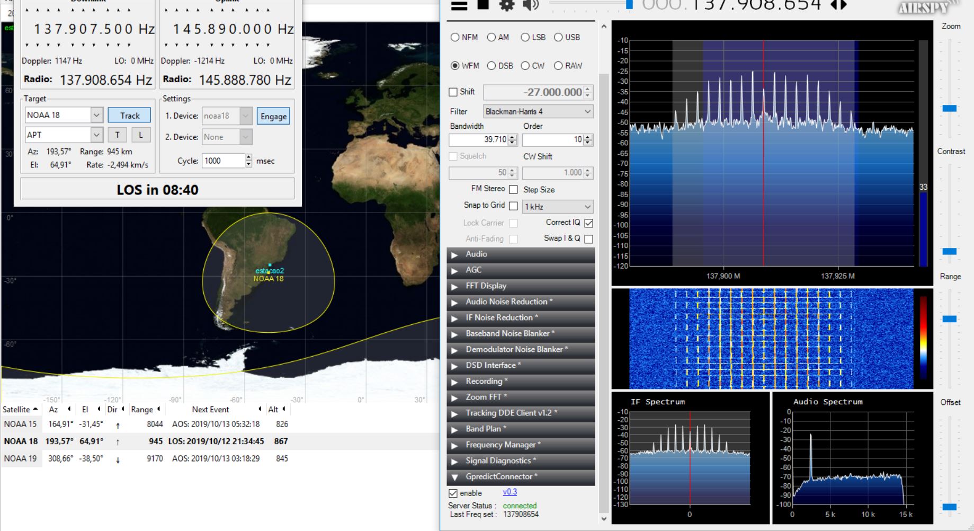
escrita/experimental/Capturar.JPG
