MatheusOgata/TCC-FESP/escrita/experimental/configWX.JPG

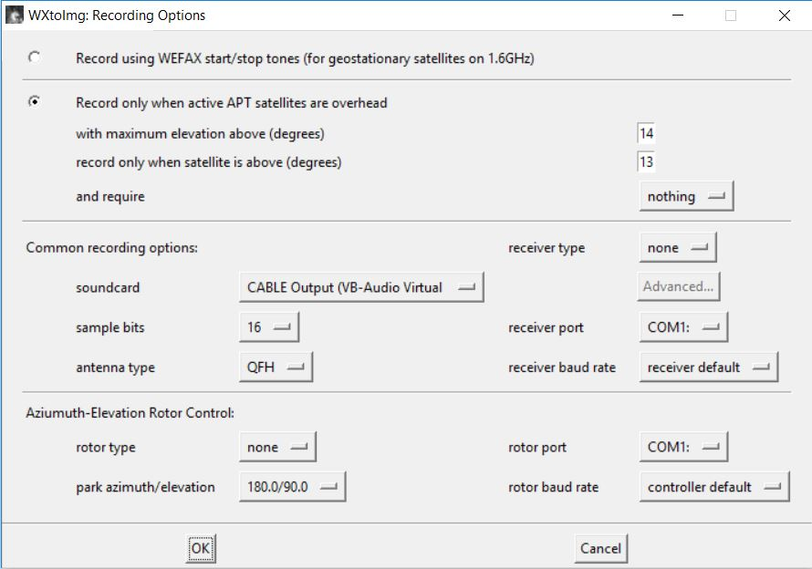
escrita/experimental/configWX.JPG
