MatheusOgata/TCC-FESP/escrita/experimental/espectro-noaa-15.JPG

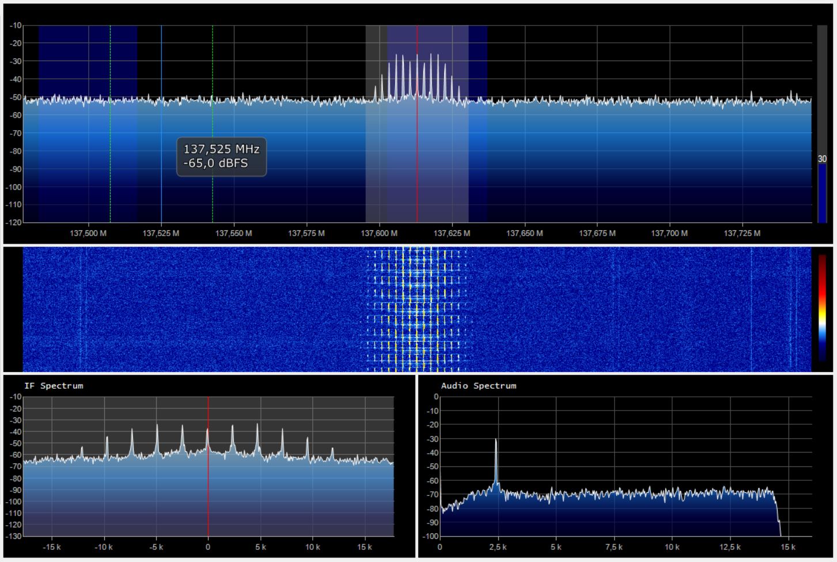
escrita/experimental/espectro-noaa-15.JPG
