MatheusOgata/TCC-FESP/escrita/experimental/exemp-sinal2-noaa19.JPG

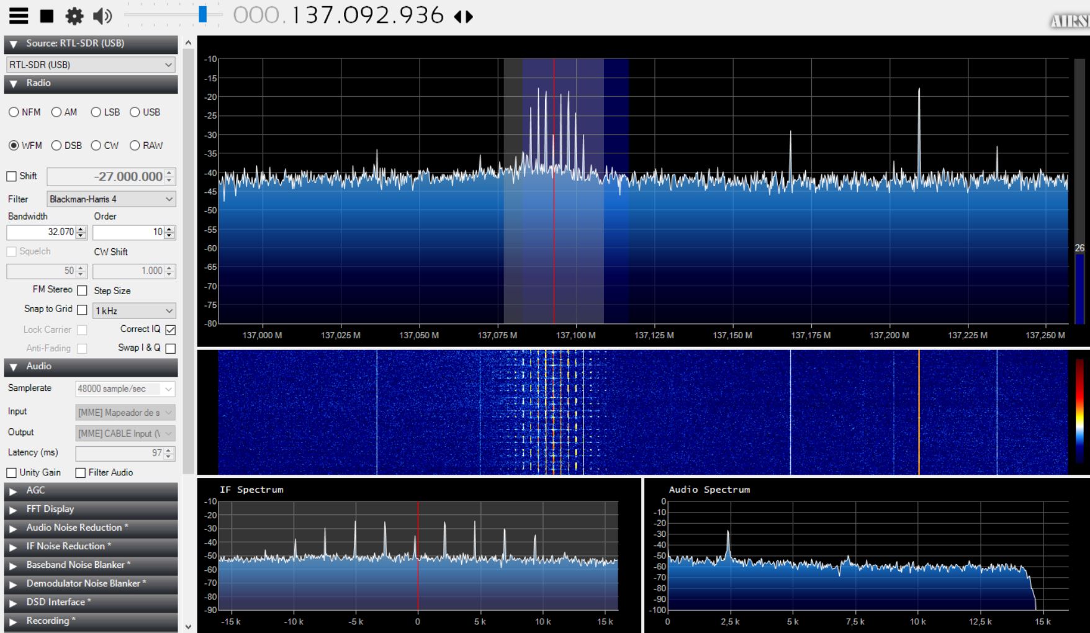
escrita/experimental/exemp-sinal2-noaa19.JPG
