MatheusOgata/TCC-FESP/escrita/experimental/exemp-sinal-noaa19.JPG

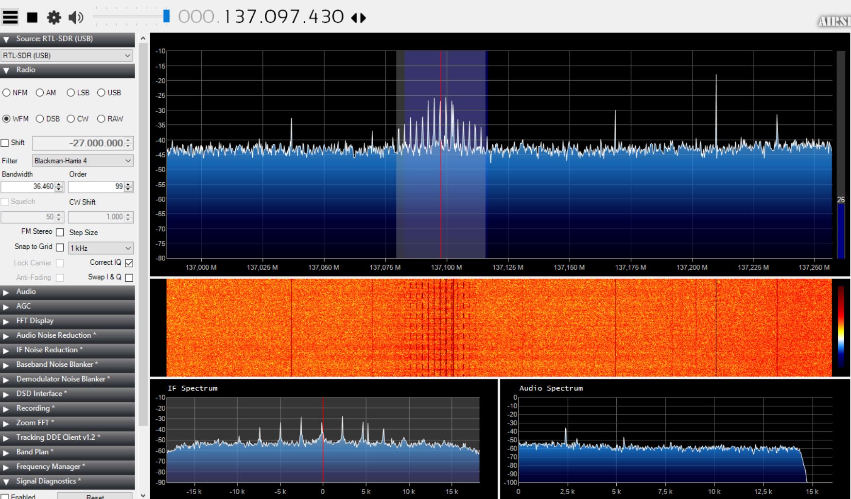
escrita/experimental/exemp-sinal-noaa19.JPG
