MatheusOgata/TCC-FESP/escrita/experimental/noaa15-gpredict.JPG

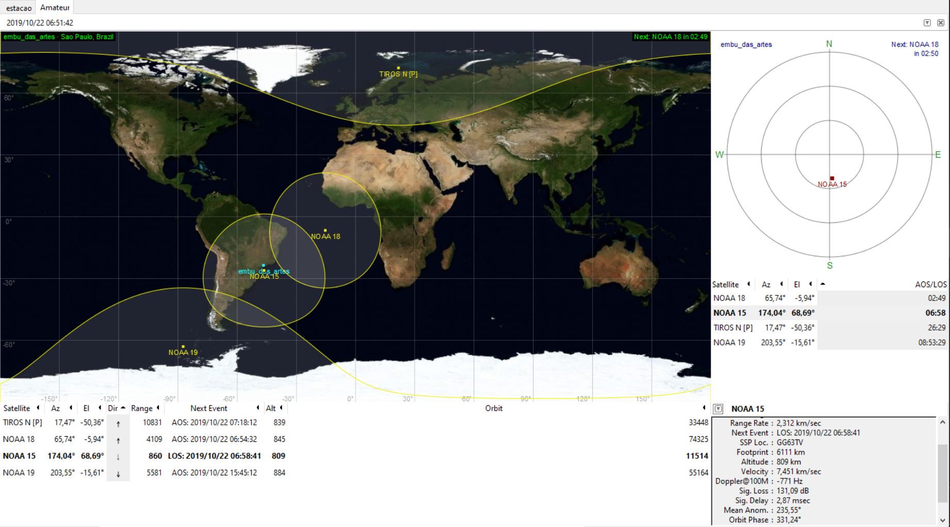
escrita/experimental/noaa15-gpredict.JPG
