MatheusOgata/TCC-FESP/escrita/experimental/noaa15-sdr#-img.JPG

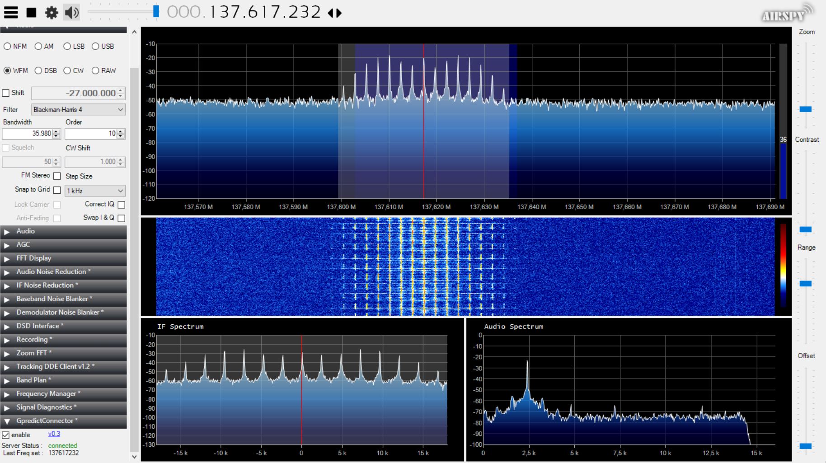
escrita/experimental/noaa15-sdr#-img.JPG
