MatheusOgata/TCC-FESP/escrita/experimental/WhatsApp Image 2019-09-18 at 00.44.19 (2).jpeg

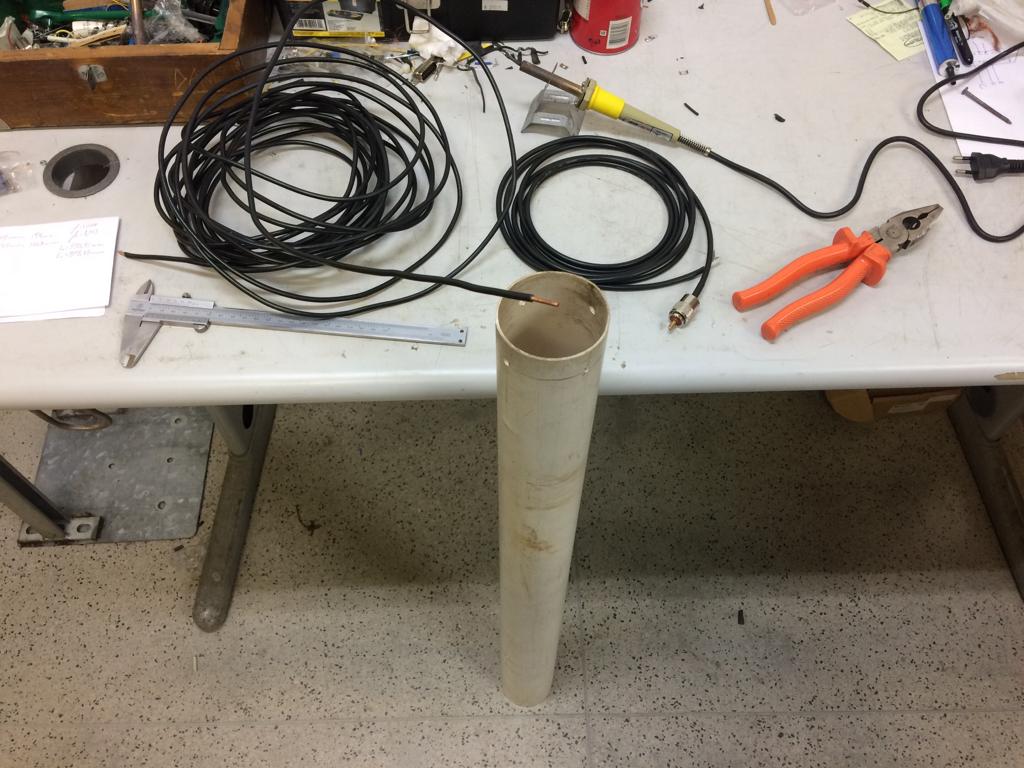
escrita/experimental/WhatsApp Image 2019-09-18 at 00.44.19 (2).jpeg
