MatheusOgata/TCC-FESP/escrita/pesquisa-antena/teste2.jpeg

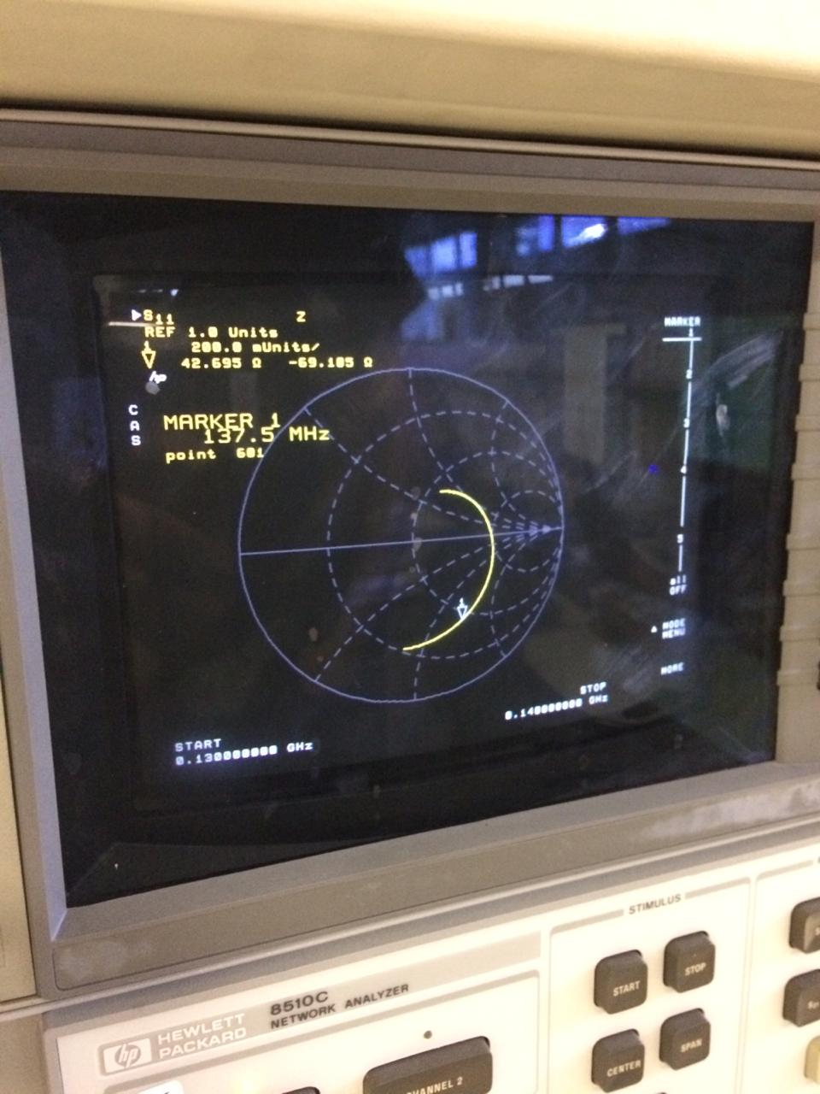
escrita/pesquisa-antena/teste2.jpeg
