MatheusOgata/TCC-FESP/escrita/pesquisa-antena/teste4.jpeg

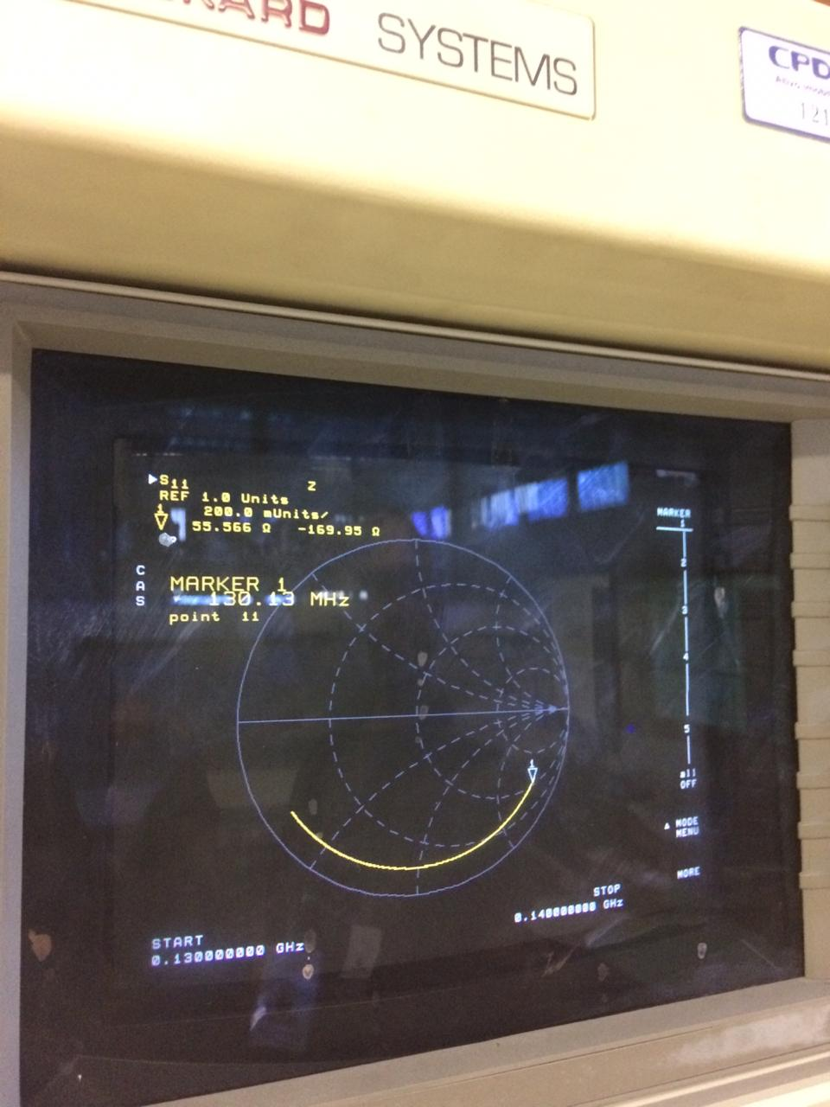
escrita/pesquisa-antena/teste4.jpeg
