MatheusOgata/TCC-FESP/(list of files, drawings)

Other design files:
escrita/pesquisa-antena/simulacao modelo antena/casador.ms14
escrita/pesquisa-antena/simulacao modelo antena/Design1.ms14
