MatheusOgata/TCC-FESP/(commit log)

2019-05-13 Numeração de páginas
2019-06-05 inclusão de handbook manitoramento VHF/UHF
2019-08-22 adição de trabalhos semelhantes e artigos
2019-08-26 branch para pesquisa da antena de polarizacao circular
2019-08-27 livros e apostilas para referencia e pesquisa
2019-09-06 pesquisa satelite, faltando colar figuras
    [tabela espectro avhrr.xlsx]
2019-09-06 pesquisa antena
    [Design1.ms14]
2019-09-07 arquivos deletados para organização
2019-09-09 a concluir - inserir figuras, testes em lab, inserir referencias
    [Design1.ms14]
2019-09-09 temas para desenvolvimento da parte introdutoria
2019-09-09 equacoes para antena e cabo coaxial feitas
2019-09-10 programa para simulação de antenas
2019-09-16 inicio experimental com aquisicao de fotos com 3 passagens diferentes
2019-09-21 componentes para casamento de impedancias
2019-09-23 inclusao para estudo da impedancia e perda de retorno da antena
2019-09-24 inicio do artigo para antena
2019-09-30 andamento do artigo para antena
2019-09-30 conclusao do artigo para antena
2019-10-04 monografia para impressao
2019-10-27 aquisicao de imagens raw 27-10
2019-10-28 aquisicao de imagens raw, atualizacao
